MathisRojas/Carte_Wifi/Diagrammes/diagramme_des_exigences.png

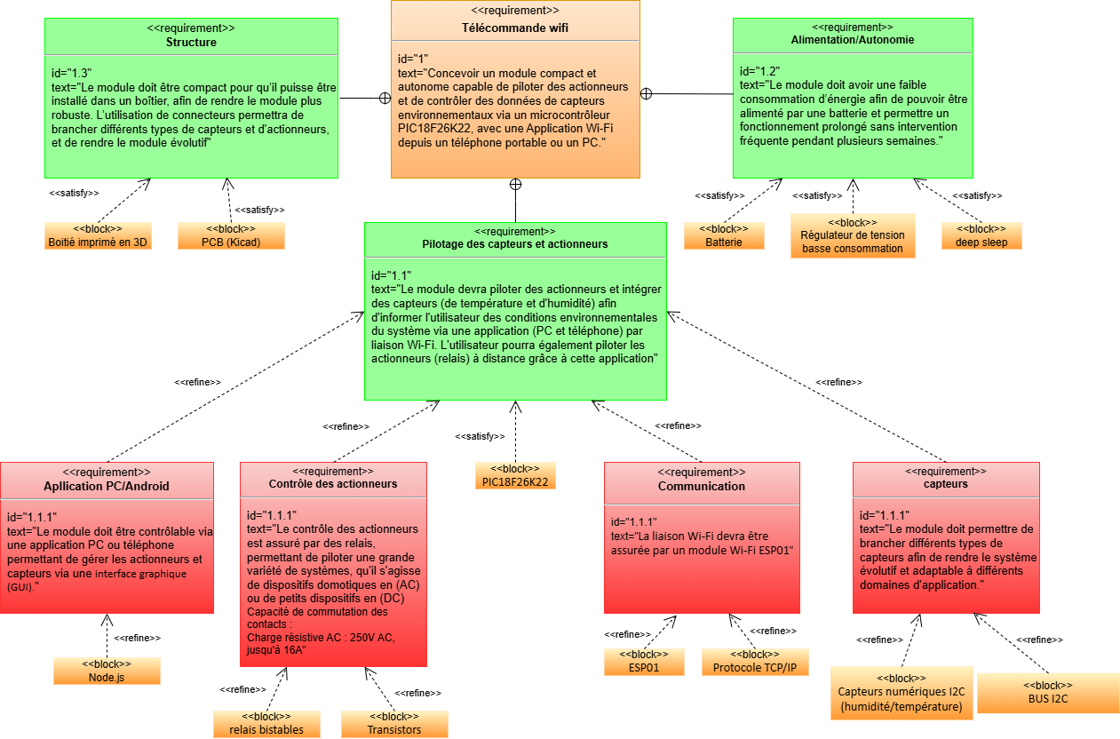
Diagrammes/diagramme_des_exigences.png
