MathisRojas/Carte_Wifi/readme.txt

Ce dossier contient l'ensemble des fichiers relatifs à la réalisation au projet :

1. Bilan produit

	Analyse de l'impact environnemental du projet (BBD 2011).

2. Diagrammes

	Inclut les différents schémas et diagrammes nécessaires à la compréhension du projet :

		Diagrammes des cas d'utilisation
		Diagrammes des exigences
		Algorigrammes

3. Documents utiles

	Regroupe les documents de référence et les documents techniques :

		Bibliographie

		Datasheets des composants utilisés :

			SHT21 (capteur d'humidité et de température)
			Relais
			ESP01 (module Wifi)

4. Electronique

	Documents et fichiers de conception électronique :

		Liste des composants électroniques utilisés (prix et référence fournisseur)
		Carte WiFi : fichier KiCad, typons, plan de perçage et d’implémentation, fichiers G-code et FlatCAM pour CNC
		Carte capteurs : fichier KiCad, typons, plan de perçage et d’implémentation

5. Planning

	Inclut le suivi du projet, le planning prévisionnel et l'état d'avancement des différentes étapes.

6. Programmes

	Contient les fichiers et codes liés aux développements logiciels :

		Carte WiFi : Programme C du microcontrôleur (PIC18F26K22)
		Application Node.js : scripts et fichiers de l'application

7.A la racine du dossier :

	Vidéo de présentation
	Manuel d'utilisation
	Rapport technique du projet
