MathisRojas/Carte_Wifi/Manuel d'utilisation.pdf

# Manuel d’utilisation -Carte Wifi

### 1. Caractéristiques Techniques

- Intervalle d'humidité relative : 0 % à 100 %
- Précision de l'humidité relative : +/- 2 %
- Température de fonctionnement : -40 °C à 125 °C
- Précision de la température : +/- 0.3 °C
- Alimentation : 3V à 6V
- Consommation moyenne : 90 mA à 5,5V

### 2. Mise en service

1. Alimenter la carte avec une tension comprise entre 3V et 6V.
2. Pour Windows, lancer le fichier code-node-js.exe
3. Pour linux, lancer la machine virtuelle mint32, ouvrir le terminal et aller dans le dossier /mnt/Documents/app. Ensuite exécuter ‘node server.js’ et ouvrir le lien qui apparait dans la console.

### 3. Connexion à l'application

1. Scanner les réseaux WiFi disponibles sur votre appareil (ordinateur, smartphone).
2. Sélectionner le SSID "Carte_Wifi".
3. Entrer le mot de passe : "mot_de_passe".
4. Cliquer sur "Se connecter".

### 4. Connexion au serveur TCP

1. Cliquez sur "Se connecter au serveur TCP"
2. Une fois connecté, une page s'affichera avec :
- Une actualisation toutes les 5 secondes des valeurs de la température et de l’humidité.
- Des boutons permettant de permuter l’état des relais à distance.

### 5. En cas de panne

1. Vérifiez que votre appareil reste connecté au réseau "Carte_Wifi".
2. En cas de problème de connexion, appuyez sur le bouton poussoir « reset ESP », puis sur le « bouton poussoir reset PIC ».
3. Si le problème persiste, branchez le Pickit3 sur la carte Wifi et compilez le programme « V8_CMS_FINAL ».

### Fin du manuel
