MathisRojas/Carte_Wifi/application/README.md

Projet Carte-wifi,

Ce projet est fait durant la 2ème année de BUT GEII à l'UGA, parcour ESE

Le but est de faire une caret wifi et une interface pour communiquer avec cette carte et recevoir des informations venant d'un capteur I²C.
