MathisRojas/Carte_Wifi/Diagrammes/algorigramme_Carte_Wifi.png

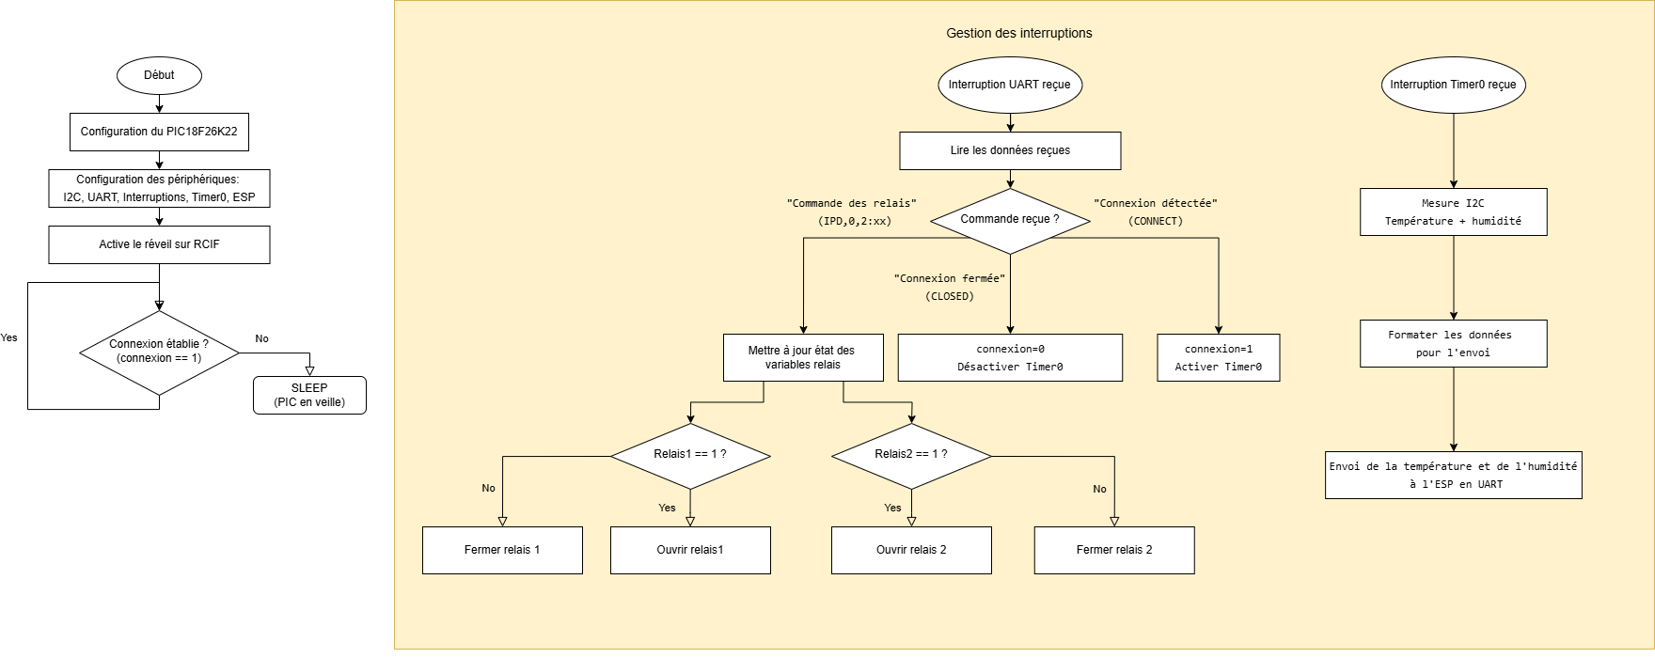
Diagrammes/algorigramme_Carte_Wifi.png
