MathisRojas/Carte_Wifi/Bilan_Produit/Bilan_Produit_Logiciel_Carte_Wifi.xls

Sheet: Crédits
L'Université de Cergy-Pontoise
Retour
Le master professionnel "Sciences de l’Environnement - Milieux Urbains et Industriels" vise à former des spécialistes capables de comprendre les enjeux environnementaux en milieux urbain et industriel, dans le domaine de la communication, de l’éco-conception et de la gestion des déchets. Il bénéficie d’une forte implication des professionnels dans les enseignements, avec notamment des conventions de formation (BRGM, INERIS), des visites de sites industriels (centres d’enfouissement techniques, incinérateurs, etc.) et la participation active des étudiants au salon Pollutec.
La première année (M1) donne aux étudiants une base solide en sciences de l’environnement et s’appuie sur des enseignements en physique, chimie, biologie et sciences de la Terre, complétés par des enseignements transversaux (économie, droit, etc.).
La deuxième année (M2) est constituée d’un tronc commun et de deux parcours séparés :
- parcours éco-conception et gestion des déchets : spécialisation dans les problèmes liés aux déchets, avec en amont la conception de produits plus respectueux de l’environnement, et en aval la gestion, le traitement et la valorisation des déchets ;
- parcours environnement et communication : spécialisation dans les problèmes de communication environnementale interne et externe des entreprises privées et des administrations, notamment dans le cadre de la prévention, ainsi que dans l’analyse et la gestion des risques et des situations de crise.
Développement de Bilan Produit 2008
Développement & mise à jour méthodologie |  |  |  | Jean-François PATINGRE
Développement classeur |  |  |  | Matthieu CHACHAGNE
Correspondant ADEME |  |  | Olivier RETHORE
Origine données |  |  |  | Ecoinvent
Bilan Produit est basé sur le classeur UCPE 2004 développé par : | Jacques VIGNERON - Professeur des Universités, Jean-François PATINGRE & Frédéric Malaval - Professeurs associés, Matthieu CHACHAGNE & Stéphane Splee RABEHANTA - Assistants Recherches
Contacts
Université de Cergy-Pontoise |  | ADEME
Département des Sciences de la Terre et de l'Environnement |  | Service Eco-conception et Consommation Durable
Bâtiment E (Neuville 3.1), 4ème étage, 5, mail Gay Lussac, Neuville-sur-Oise 95031 Cergy-Pontoise Cedex |  | 27 rue Louis Vicat 75737 Paris Cedex 15
 |  | olivier.rethore@ademe.fr
jean-francois.patingre@u-cergy.fr |  | Pour toute question, consulter d'abord la Foire Aux Questions
Retour

Sheet: Pour commencer
Classeur d'Estimation des Impacts Environnementaux des Produits
DEMARRER
Bilan Produit, Base de Données actualisée en 2011
N'oubliez pas | Cellule sur fond jaune |  | = information à saisir
 | - Sur chaque feuille un clic sur le bouton "Aide" fait apparaître un guide d'utilisation et de renseignements.
 | - Pour vous familiariser avec l'outil, vous pouvez consulter l'exemple d'une cafetière intégralement traité dans le manuel d'utilisation du logiciel.
Pour en savoir plus | - Eco-conception, Concept, Méthodes, Outils, Guides et Perspectives ; Collectif ; Ed. Economica - 2001
 | - Eco-concevoir, Appliquer et Communiquer ; Collectif ; Ed. Economica - 2002
 | - Dossier Eco-conception sur le site de l'ADEME (http://www2.ademe.fr/servlet/KBaseShow?sort=-1&cid=96&m=3&catid=12922) | http://www2.ademe.fr/servlet/KBaseShow?sort=-1&cid=96&m=3&catid=12922 | http://www2.ademe.fr/servlet/KBaseShow?sort=-1&cid=96&m=3&catid=12922 | http://www2.ademe.fr/servlet/KBaseShow?sort=-1&cid=96&m=3&catid=12922 | http://www2.ademe.fr/servlet/KBaseShow?sort=-1&cid=96&m=3&catid=12922 | http://www2.ademe.fr/servlet/KBaseShow?sort=-1&cid=96&m=3&catid=12922
Bilan Produit 2008 est basé sur le classeur UCPE 2004 développé par l'équipe éco-conception de l'Université de Cergy-Pontoise, Département Sciences de la Terre et de l'Environnement. Le développement de ce classeur a été rendu possible grâce au soutien financier de l'ADEME Convention n°0377002
Crédits

Sheet: Méthodologie
 | Méthodologie
 | Précédent | Suivant
Description
Projet |  | Carte Wifi
Cas |  | Domotique
Date |  | 2025-03-10
Auteur |  | ROJAS BARRAUD
L'unité fonctionnelle
Pour comparer des produits, différentes solutions de conception ou des options d'optimisations, il est nécessaire de ramener toutes les quantifications (coûts, impacts…) à une même unité d'utilisation : l'Unité d'utilité du produit. Elle ne peut se définir que par rapport à sa fonction pour l'utilisateur. Quel service rend-t-elle ? La définition fonctionnelle sert donc directement à ce choix de la quantification unitaire, on parle alors d'Unité Fonctionnelle. Il faut donc apporter le plus grand soin à la définition d'une unité "commune" d'utilisation des produits et services avant de conclure sur les choix liés à leur éco-conception.
Détermination de l'Unité fonctionnelle
Une démarche Multi-critères & Multi-étapes
Environnement est un terme générique qui englobe des problématiques variées : réchauffement climatique, pollution des sols et des eaux, diminuation de la bio-diversité... Ces questions se manifestent à des échelles géographiques variables (locale, régionale, mondiale) et pour une période temporelle spécifique.
Pour refléter ces particularités, huit indicateurs d'impacts ont été retenus parmi tous ceux disponibles dans la littérature scientifique. Ils représentent les grands enjeux environnementaux de notre époque. On parle alors d'une approche multi-critères.
cf. Manuel Utilisateur (Définition des indicateurs)
L'étude des impacts du produit doit être considérée sur l'ensemble de son cycle de vie : fabrication, transports, utilisation et fin de vie.
D'une part pour ne pas négliger d'impact, à aucun moment. D'autre part pour éviter un phénomène de transfert de pollution. En effet l'étude d'un produit sur une seule phase du cycle de vie peut amener, lors d'une tentative d'amélioration, à baisser les impacts sur la phase considérée mais à conduire à l'augmention d'un ou plusieurs impacts à une autre étape du cycle de vie.
Phase de Production |  | Phase de Transports | Phase d'Utilisation | Fin de vie
La normation des résultats
Les indicateurs d'impacts sont exprimés dans des unités souvent peu parlantes en elles-mêmes (kg CO2 éq, kg SO2 éq...). De plus ils sont exprimés dans des unités et des ordres de grandeurs différents qui ne permettent pas d'établir entre eux une visualisation correcte.
La normation permet de passer outre ces difficultés, en établissant une référence de type temporelle et / ou géographique.
Elle ne permet cependant pas la comparaison entre indicateurs dont les problèmes et les gravités sont de natures différentes et EXCLUE toutes additivités entre eux.
Une valeur d'indicateur d'Effet de serre ne peut pas être comparée à une valeur d'indicateur de la Toxicité humaire.
La normation consiste à effectuer le rapport entre la valeur de l'impact du produit et la valeur de référence de la normation.
La normation effectuée dans ce logiciel se fait par rapport aux valeurs d'impacts de la consommation moyenne d'un européen sur une journée (Europe des Quinze). Les résultats sont alors exprimés en point UCPE (Unité de Compte de Profil Environnemental).
Il est possible de modifier ces paramètres pour changer de zone géographique, ou de durée. Cela nécessite une réflexion importante pour exclure tous doubles comptes. Pour modifier ou consulter les paramètres de normalisation, cliquez sur le bouton "Expert".
Expression des résultats
Les résultats de l'analyse sont visualisés sous formes de graphiques présentant les résultats normés et de tableaux dans lesquels les valeurs sont données sans normation.
Les résultats
Exploitation des résultats
Pour que les résultats puissent être considérés comme conformes aux normes ISO 14040 et ISO 14044 sur l'analyse de cycle de vie, il faut que la modélisation ait été soumise à revue critique.

Sheet: Unité Fonctionnelle
 | Calcul du coefficient d'unité fonctionnelle
 | Précédent | Suivant
Coefficient d'Unité Fonctionnelle (CUF)
Entrez, dans l'encadré, le coefficient d'unité fonctionnelle que vous avez déterminé :……..……………………….…………….……………..
 |  |  |  | …………….. | 1
Entrez une brève description du système modélisé :
 | 24h/24h 7j/7j
L'unité fonctionnelle peut s'exprimer sous la forme :
 | - d'une durée de vie,
 | - d'un nombre de cycle de fonctionnement,
 | - d'une quantité (consommée, de production…).
- Exemple 1 : cas d'une machine à café
A\ Unité fonctionnelle : Préparer le café du petit-déjeuner pour une famille de 4 personnes durant 5 ans.
On prend comme hypothèse que cela correspond à 300 préparations par an soit 1500 pour la période retenue.
Si la machine étudiée est prévue pour 1200 cycles de préparation de café,
 | alors le CUF équivaut à : 1500 / 1200 = 1,25
B\ Unité fonctionnelle évaluée pour une durée de 1 an.
Si la machine est prévue pour durer 5 ans,
 | Ici le CUF équivaut à : 1 / 5 = 0,2
- Exemple 2 : comparaison entre différent conditionnement d'eau minérale
Etude de la consommation d'eau minérale d'une personne sur un an, environ 150 litres.
3 cas étudiés :
 |  |  | CUF
 | Bouteille de verre de 1L |  | 150
 | Bouteille de plastique (PET) de 50 cL |  | 300
 | Cannette en Alu de 33 cL |  | 455
Voir exemples du manuel utilisateur

Sheet: Phase de Production
 | Phase de Production
 | Précédent | Suivant
 | Tableau des éléments (Composants…) du produit
Sous-ensemble | Nom | Quantité | Unité | Commentaires utilisateur
PCB | Circuit imprimé composants traversants (surface) | 0.00299 | m2 | PCB
PCB2 | Circuit imprimé CMS (surface) | 0.000225 | m2 | PCB_capteurs
PCBA | Composant électronique passif (moyenne) | 0.00684 | kg | capacités
PCBA | Composant électronique actif (moyenne) | 0.00033 | kg | diodes
PCBA | Composant électronique actif (moyenne) | 4.2e-05 | kg | XC9236A33DMR-G
PCBA | Composant électronique passif (moyenne) | 4e-05 | kg | inductance
PCBA | Composant électronique passif (moyenne) | 5.5e-08 | kg | résistances
PCBA | Composants de panneau d'ordinateur | 4.5e-05 | kg | embases à broches males
PCBA | Composants de panneau d'ordinateur | 0.0055 | kg | borniers
PCBA | Composants de panneau d'ordinateur | 0.000938 | kg | Embases et logements de câbles
PCBA | Composant électronique passif (moyenne) | 0.028 | kg | Relais RT314F03
PCBA | Module electronique de commande | 0.001 | kg | ESP
PCBA | Module electronique de commande | 0.000792 | kg | PIC
PCBA | Composant électronique passif (moyenne) | 0.004 | kg | boutons poussoirs
PCBA | Composant électronique actif (moyenne) | 4e-05 | kg | Transistors
PCBB | Module electronique de commande | 2.5e-05 | kg | SHT21

Sheet: Phase de Transports
 | Phase de Transports
 | Précédent | Suivant
 | Tableau des transports liés au produit
Sous-ensemble | Nom | Quantité | Unité | Commentaires utilisateur
TRANSPORT | Transport transocéanique | 1.026 | t.km | Distance : 18000km Masse transportée : 0,057kg
TRANSPORT | Petit camion 3,5 à 16 T (moyenne européenne) | 0.017328 | t.km | Distance : 304km Masse transportée : 0,057kg

Sheet: Phase Utilisation
 | Phase d'Utilisation
 | Précédent | Suivant
 | Tableau des éléments (Composants…) du produit
Sous-ensemble | Nom | Quantité | Unité | Commentaires utilisateur
électricité | Electricité basse tension France | 0.0003 | kWh

Sheet: Fin de vie
 |  | Fin de vie
 |  | Précédent | Suivant
 | Nom du scénario : | Déchets ménagers
Phase de vie | Sous-ensemble | Matériaux | % Recyclage | % Incinération | % Enfouissement | % Compostage | Validation
Phase de Production | PCB | Circuit imprimé composants traversants (surface) | 75.00% | 12.50% | 12.50% | 0.00% | 100.00%
Phase de Production | PCB2 | Circuit imprimé CMS (surface) | 75.00% | 12.50% | 12.50% | 0.00% | 100.00%
Phase de Production | PCBA | Composant électronique passif (moyenne) | 75.00% | 12.50% | 12.50% | 0.00% | 100.00%
Phase de Production | PCBA | Composant électronique actif (moyenne) | 75.00% | 12.50% | 12.50% | 0.00% | 100.00%
Phase de Production | PCBA | Composant électronique actif (moyenne) | 75.00% | 12.50% | 12.50% | 0.00% | 100.00%
Phase de Production | PCBA | Composant électronique passif (moyenne) | 75.00% | 12.50% | 12.50% | 0.00% | 100.00%
Phase de Production | PCBA | Composant électronique passif (moyenne) | 75.00% | 12.50% | 12.50% | 0.00% | 100.00%
Phase de Production | PCBA | Composants de panneau d'ordinateur | 75.00% | 12.50% | 12.50% | 0.00% | 100.00%
Phase de Production | PCBA | Composants de panneau d'ordinateur | 75.00% | 12.50% | 12.50% | 0.00% | 100.00%
Phase de Production | PCBA | Composants de panneau d'ordinateur | 75.00% | 12.50% | 12.50% | 0.00% | 100.00%
Phase de Production | PCBA | Composant électronique passif (moyenne) | 75.00% | 12.50% | 12.50% | 0.00% | 100.00%
Phase de Production | PCBA | Module electronique de commande | 75.00% | 12.50% | 12.50% | 0.00% | 100.00%
Phase de Production | PCBA | Module electronique de commande | 75.00% | 12.50% | 12.50% | 0.00% | 100.00%
Phase de Production | PCBA | Composant électronique passif (moyenne) | 75.00% | 12.50% | 12.50% | 0.00% | 100.00%
Phase de Production | PCBA | Composant électronique actif (moyenne) | 75.00% | 12.50% | 12.50% | 0.00% | 100.00%
Phase de Production | PCBB | Module electronique de commande | 75.00% | 12.50% | 12.50% | 0.00% | 100.00%

Sheet: Résultats
 |  | Résultats
 | Précédent
Impacts par phase de vie
Indicateurs | Phase de Production | Phase de Transports | Phase Utilisation | Fin de vie |  | Total
Consommation énergie NR (MJ eq) | 59.91886105 | 0.2475498154 | 0.00390024027 | 0 |  | 60.1703111
Consommation ressources (kg Sb eq) | 0.02834421451 | 0.0001049200368 | 2.14968e-07 | 0 |  | 0.02844934952
Effet de serre GWP 100 mod (kg CO2 eq) | 3.707115544 | 0.01546603344 | 3.2235e-05 | 0 |  | 3.722613813
Acidification (kg SO2 eq) | 0.05455235361 | 0.000265083744 | 2.03523e-07 | 0 |  | 0.05481764088
Eutrophisation (air eau sol) (kg PO4--- eq) | 0.026293604 | 3.273683736e-05 | 8.8719e-08 | 0 |  | 0.02632642956
Pollution photochimique (kg C2H4) | 0.004324063094 | 8.42518368e-06 | 7.917e-09 | 0 |  | 0.004332496194
Ecotoxicité aquatique (kg 1,4-DB eq) | 6.328833806 | 0.001659267264 | 2.17398e-05 | 0 |  | 6.330514813
Toxicité humaine (kg 1,4-DB eq) | 10.53276769 | 0.008838226656 | 7.3245e-05 | 0 |  | 10.54167916
Impacts par Sous-ensemble - Phase de Production
Indicateurs | Circuit imprimé composants traversants (surface) (PCB) | Circuit imprimé CMS (surface) (PCB2) | Composant électronique passif (moyenne) (PCBA) | Composant électronique actif (moyenne) (PCBA) | Composant électronique actif (moyenne) (PCBA) | Composant électronique passif (moyenne) (PCBA) | Composant électronique passif (moyenne) (PCBA) | Composants de panneau d'ordinateur (PCBA) | Composants de panneau d'ordinateur (PCBA) | Composants de panneau d'ordinateur (PCBA) | Composant électronique passif (moyenne) (PCBA) | Module electronique de commande (PCBA) | Module electronique de commande (PCBA) | Composant électronique passif (moyenne) (PCBA) | Composant électronique actif (moyenne) (PCBA) | Module electronique de commande (PCBB)
Consommation énergie NR (MJ eq) | 5.480768744 | 1.138208479 | 5.762103223 | 3.844569938 | 0.4893089011 | 0.03369651008 | 4.633270135e-05 | 0.1038515197 | 12.69296352 | 2.164727233 | 23.58755705 | 0.4322510245 | 0.3423428114 | 3.369651008 | 0.4660084773 | 0.01080627561
Consommation ressources (kg Sb eq) | 0.0021969922 | 0.000444105 | 0.0027887364 | 0.001725009 | 0.0002195466 | 1.63084e-05 | 2.242405e-08 | 5.0985e-05 | 0.0062315 | 0.001062754 | 0.01141588 | 0.00019397 | 0.00015362424 | 0.00163084 | 0.000209092 | 4.84925e-06
Effet de serre GWP 100 mod (kg CO2 eq) | 0.3072225 | 0.064161 | 0.33456492 | 0.2420847 | 0.03081078 | 0.00195652 | 2.690215e-06 | 0.00752895 | 0.920205 | 0.15693678 | 1.369564 | 0.025912 | 0.020522304 | 0.195652 | 0.0293436 | 0.0006478
Acidification (kg SO2 eq) | 0.0015760589 | 0.0003422025 | 0.007546572 | 0.001210506 | 0.0001540644 | 4.4132e-05 | 6.06815e-08 | 5.47785e-05 | 0.00669515 | 0.0011418274 | 0.0308924 | 0.00018419 | 0.00014587848 | 0.0044132 | 0.000146728 | 4.60475e-06
Eutrophisation (air eau sol) (kg PO4--- eq) | 0.0011725584 | 0.000325665 | 0.00346617 | 0.002785629 | 0.0003545346 | 2.027e-05 | 2.787125e-08 | 8.06805e-06 | 0.000986095 | 0.00016817402 | 0.014189 | 0.00024918 | 0.00019735056 | 0.002027 | 0.000337652 | 6.2295e-06
Pollution photochimique (kg C2H4) | 7.139522e-05 | 1.4292225e-05 | 0.00067488912 | 4.44807e-05 | 5.66118e-06 | 3.94672e-06 | 5.42674e-09 | 2.26737e-06 | 0.000277123 | 4.7262068e-05 | 0.002762704 | 1.0992e-05 | 8.705664e-06 | 0.000394672 | 5.3916e-06 | 2.748e-07
Ecotoxicité aquatique (kg 1,4-DB eq) | 0.26007618 | 0.06460425 | 0.853974 | 0.683529 | 0.0869946 | 0.004994 | 6.86675e-06 | 0.00128421 | 0.156959 | 0.026768644 | 3.4958 | 0.061415 | 0.04864068 | 0.4994 | 0.082852 | 0.001535375
Toxicité humaine (kg 1,4-DB eq) | 0.7112911 | 0.150975 | 1.390572 | 0.957957 | 0.1219218 | 0.008132 | 1.11815e-05 | 0.00266571 | 0.325809 | 0.055565244 | 5.6924 | 0.10245 | 0.0811404 | 0.8132 | 0.116116 | 0.00256125
Impacts par Sous-ensemble - Phase de Transports
Indicateurs | Transport transocéanique (TRANSPORT) | Petit camion 3,5 à 16 T (moyenne européenne) (TRANSPORT)
Consommation énergie NR (MJ eq) | 0.1716089522 | 0.07594086319
Consommation ressources (kg Sb eq) | 7.3268712e-05 | 3.16513248e-05
Effet de serre GWP 100 mod (kg CO2 eq) | 0.011013084 | 0.00445294944
Acidification (kg SO2 eq) | 0.0002417256 | 2.3358144e-05
Eutrophisation (air eau sol) (kg PO4--- eq) | 2.641437e-05 | 6.32246736e-06
Pollution photochimique (kg C2H4) | 7.68987e-06 | 7.3531368e-07
Ecotoxicité aquatique (kg 1,4-DB eq) | 0.0012262752 | 0.000432992064
Toxicité humaine (kg 1,4-DB eq) | 0.0076603212 | 0.001177905456
Impacts par Sous-ensemble - Phase Utilisation
Indicateurs | Electricité basse tension France (électricité)
Consommation énergie NR (MJ eq) | 0.00390024027
Consommation ressources (kg Sb eq) | 2.14968e-07
Effet de serre GWP 100 mod (kg CO2 eq) | 3.2235e-05
Acidification (kg SO2 eq) | 2.03523e-07
Eutrophisation (air eau sol) (kg PO4--- eq) | 8.8719e-08
Pollution photochimique (kg C2H4) | 7.917e-09
Ecotoxicité aquatique (kg 1,4-DB eq) | 2.17398e-05
Toxicité humaine (kg 1,4-DB eq) | 7.3245e-05
Impacts par Sous-ensemble - Fin de vie
Indicateurs | Circuit imprimé composants traversants (surface) (Phase de Production : PCB) | Circuit imprimé CMS (surface) (Phase de Production : PCB2) | Composant électronique passif (moyenne) (Phase de Production : PCBA) | Composant électronique actif (moyenne) (Phase de Production : PCBA) | Composant électronique actif (moyenne) (Phase de Production : PCBA) | Composant électronique passif (moyenne) (Phase de Production : PCBA) | Composant électronique passif (moyenne) (Phase de Production : PCBA) | Composants de panneau d'ordinateur (Phase de Production : PCBA) | Composants de panneau d'ordinateur (Phase de Production : PCBA) | Composants de panneau d'ordinateur (Phase de Production : PCBA) | Composant électronique passif (moyenne) (Phase de Production : PCBA) | Module electronique de commande (Phase de Production : PCBA) | Module electronique de commande (Phase de Production : PCBA) | Composant électronique passif (moyenne) (Phase de Production : PCBA) | Composant électronique actif (moyenne) (Phase de Production : PCBA) | Module electronique de commande (Phase de Production : PCBB)
Consommation énergie NR (MJ eq) | 0 | 0 | 0 | 0 | 0 | 0 | 0 | 0 | 0 | 0 | 0 | 0 | 0 | 0 | 0 | 0
Consommation ressources (kg Sb eq) | 0 | 0 | 0 | 0 | 0 | 0 | 0 | 0 | 0 | 0 | 0 | 0 | 0 | 0 | 0 | 0
Effet de serre GWP 100 mod (kg CO2 eq) | 0 | 0 | 0 | 0 | 0 | 0 | 0 | 0 | 0 | 0 | 0 | 0 | 0 | 0 | 0 | 0
Acidification (kg SO2 eq) | 0 | 0 | 0 | 0 | 0 | 0 | 0 | 0 | 0 | 0 | 0 | 0 | 0 | 0 | 0 | 0
Eutrophisation (air eau sol) (kg PO4--- eq) | 0 | 0 | 0 | 0 | 0 | 0 | 0 | 0 | 0 | 0 | 0 | 0 | 0 | 0 | 0 | 0
Pollution photochimique (kg C2H4) | 0 | 0 | 0 | 0 | 0 | 0 | 0 | 0 | 0 | 0 | 0 | 0 | 0 | 0 | 0 | 0
Ecotoxicité aquatique (kg 1,4-DB eq) | 0 | 0 | 0 | 0 | 0 | 0 | 0 | 0 | 0 | 0 | 0 | 0 | 0 | 0 | 0 | 0
Toxicité humaine (kg 1,4-DB eq) | 0 | 0 | 0 | 0 | 0 | 0 | 0 | 0 | 0 | 0 | 0 | 0 | 0 | 0 | 0 | 0
