MathisRojas/Carte_Wifi/Electronique/Liste_des_composants_électroniques.xls

Désignation // Référence | Qte | PU HT | PT HT | OBSERVATIONS | FOURNISSEUR
2948328 | 5 |  | 3.29 | Transistors NPN (2SCR514RTL) | Farnell (https://fr.farnell.com/rohm/2scr514rtl/transistor-npn-80v-0-7a-sot-346t/dp/2948328)
1855468 | 1 | 8.39 | 8.39 | SHT21 capteur de température et d'humidité en I2C | Farnell (https://fr.farnell.com/sensirion/sht21/capteur-humidite-temperature-num/dp/1855468)
2432863 | 2 | 4.11 | 8.22 | G5RLU1E DC3 relai bistable 3VDC | Farnell (https://fr.farnell.com/omron/g5rlu1edc3/relais-spdt-250vac-24vdc-16a/dp/2432863)
3535681 | 1 | 1.74 | 1.74 | XC9236A33DMR-G Régulateur de tension à découpage 3,3V | Farnell (https://fr.farnell.com/torex/xc9236a33dmr-g/conv-dc-dc-sync-buck-3mhz-85-c/dp/3535681)
2084899 | 1 | 0.35 | 0.35 | NR3015T1R5N inductance 1,5uH | Farnell (https://fr.farnell.com/taiyo-yuden/nr3015t1r5n/inductor-shielded-1-5uh-1-8a-smd/dp/2084899)
34952 | 1 | 8.25 | 8.25 | ESP01 | GOTRONIC (https://www.gotronic.fr/art-module-wifi-esp-01-25664.htm)
715-4454 | 1 | 3.26 | 3.26 | PIC18F26K22 (CMS) | RS (https://fr.rs-online.com/web/p/microcontroleurs/7154454)
 | 2 | 3.74 | 7.48 | Relais (RT314F03) | AliExpress (https://fr.aliexpress.com/item/4000871580820.html)
2675138 | 5 |  | 4.24 | Diodes (SS24) | Farnell (https://fr.farnell.com/multicomp-pro/ss24/redresseur-schottky-2a-40v-do/dp/2675138)
3924322 | 5 |  | 1.02 | Condensateur céramique 100nF 1206 | Farnell (https://fr.farnell.com/yageo/cs1206kkx7rybb104/condensateur-0-1uf-250v-mlcc-1206/dp/3924322)
708-3841 | 5 |  | 5.39 | Condensateur Radial 1000μF | RS (https://fr.rs-online.com/web/p/condensateurs-electrolytiques-aluminium/7083841?gb=s)
4166270 | 5 |  | 1.38 | Condensateur céramique 4.7 µf 1206 | Farnell (https://fr.farnell.com/yageo/cs1206kkx7r8bb475/cond-4-7uf-25v-mlcc-1206/dp/4166270)
4167011 | 5 |  | 1.15 | Condensateur céramique 10µf 1206 | Farnell (https://fr.farnell.com/yageo/cc1206mkx5r5bb106/cond-10uf-6-3v-mlcc-1206/dp/4167011)
767-0996 | 3 | 0.75 | 2.25 | Embase à broches 8 pôles 2.54mm 1 rangée | RS (https://fr.rs-online.com/web/p/embases-circuits-imprimes/7670996?matchtype=&gad_source=1&gclsrc=aw.ds)
765-5626 | 1 | 1.94 | 1.94 | Connecteur femelle, 8 contacts, 2 rangées, 2.54mm | RS (https://fr.rs-online.com/web/p/connecteurs-femelles-pour-ci/7655626?matchtype=&gad_source=1&gclsrc=aw.ds)
269-3801 | 2 | 0.25 | 0.50 | Interrupteur tactile Schurter Traversant | RS (https://fr.rs-online.com/web/p/interrupteurs-tactiles/2693801?matchtype=&gad_source=1&gclsrc=aw.ds)
3498390 | 2 | 0.91 | 1.82 | Bornier fil-à-carte, 5 mm, 3 Voies | farnell (https://fr.farnell.com/camdenboss/ctb0100-3/terminal-block-interlocking-3/dp/3498390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)
826-7282 | 1 | 0.85 | 0.85 | Bornier 2 contacts 1 rangée | RS (https://fr.rs-online.com/web/p/borniers-pour-circuits-imprimes/8267282?matchtype=&gad_source=1&gclsrc=aw.ds)
668-8524 | 2 | 0.95 | 1.90 | Résistance CMS 10kΩ, 0805 (2012M) ±0.1% (lot de 5) | RS (https://fr.rs-online.com/web/p/resistances-a-montage-en-surface/6688524?gb=s)
3599183 | 1 | 2.47 | 2.47 | Résistance à puce CMS, 2.2 kohm, ± 0.5% (lot de 10) | farnell (https://fr.farnell.com/panasonic/erjup6d2201v/res-2k2-0-5-0-5w-0805/dp/3599183)
 |  |  | 0.00
 |  |  | 0.00
 |  |  | 0.00
 |  |  | 0.00
 | TOTAL HT = |  | 65.89
 | TVA 20% = |  | 13.18
 | TOTAL TTC = |  | 79.07
