MathisRojas/Carte_Wifi/Electronique/bibliothèque/2SCR514RTL/3D/2SCR514RTL.stp

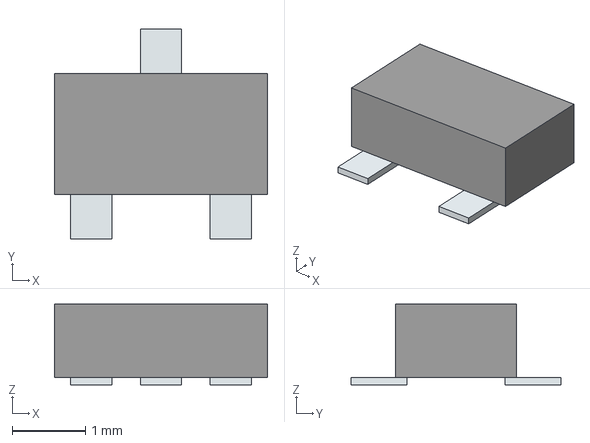
[picture p23: CAD file, 2025-04-15]
Electronique/bibliothèque/2SCR514RTL/3D/2SCR514RTL.stp
2.90 x 2.86 x 1.10 mm
Pins
