MathisRojas/Carte_Wifi/Electronique/bibliothèque/ESP-01.step

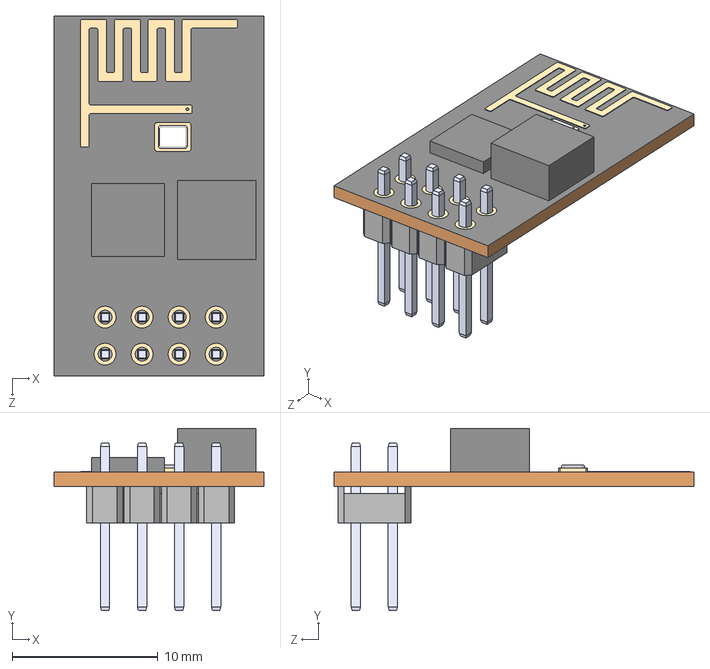
[picture p24: CAD file, 2025-04-15]
Electronique/bibliothèque/ESP-01.step
14.4 x 12.5 x 24.7 mm
