MathisRojas/Carte_Wifi/Electronique/bibliothèque/Librairie_Kicad_2021_11_29/STEP/L7815CV.step

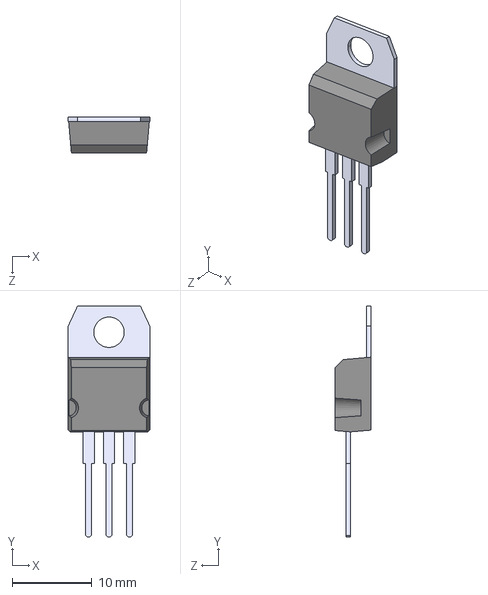
[picture p25: CAD file, 2025-04-15]
Electronique/bibliothèque/Librairie_Kicad_2021_11_29/STEP/L7815CV.step
10.2 x 28.9 x 4.50 mm
