MathisRojas/Carte_Wifi/Electronique/bibliothèque/SHT21/3D/SHT21.stp

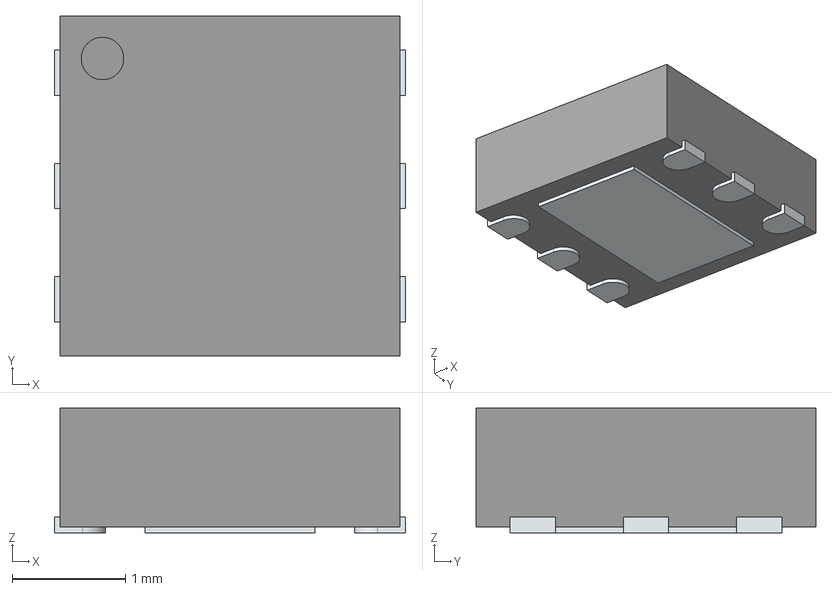
[picture p26: CAD file, 2025-04-15]
Electronique/bibliothèque/SHT21/3D/SHT21.stp
3.10 x 3.00 x 1.10 mm
ThermalPin
PinsArrayLR
