MathisRojas/Carte_Wifi/Electronique/bibliothèque/XC9236A33DMR-G/3D/XC9236A33DMR-G.stp

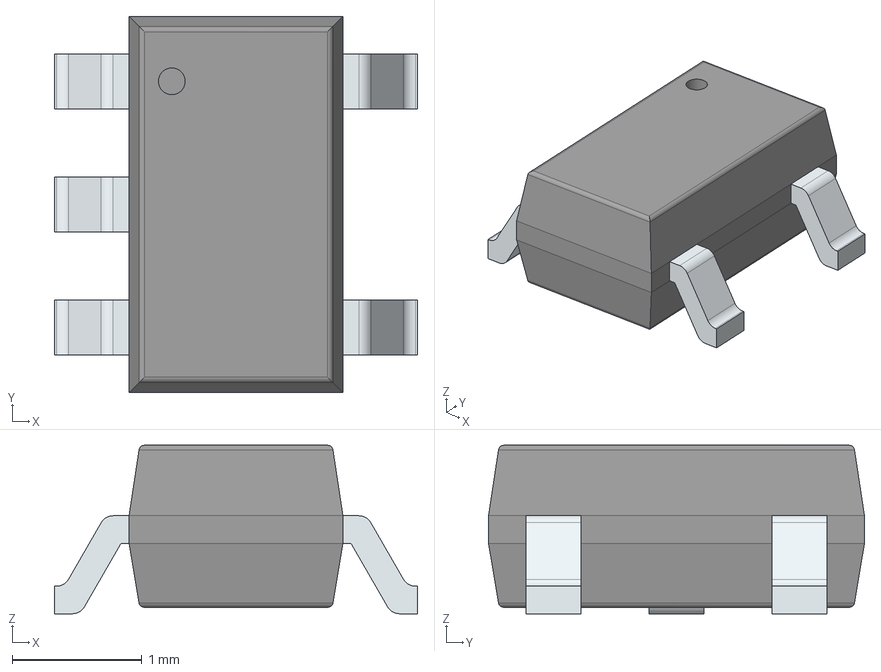
[picture p27: CAD file, 2025-04-15]
Electronique/bibliothèque/XC9236A33DMR-G/3D/XC9236A33DMR-G.stp
2.80 x 2.90 x 1.30 mm
PinsArrayL
PinsArrayR
