MathisRojas/Carte_Wifi/(list of files, cad)

Other CAD files:
Electronique/bibliothèque/2SCR514RTL/Allegro/2scr514rtl.psm
Electronique/bibliothèque/2SCR514RTL/DEHDL/2scr514rtl/chips/chips.prt
Electronique/bibliothèque/G5RL-U1-E-DC3/Allegro/g5rlu1e.psm
Electronique/bibliothèque/G5RL-U1-E-DC3/DEHDL/g5rl_u1_e_dc3/chips/chips.prt
Electronique/bibliothèque/NR3015T1R5N/Allegro/nr3015.psm
Electronique/bibliothèque/NR3015T1R5N/DEHDL/nr3015t1r5n/chips/chips.prt
Electronique/bibliothèque/SHT21/Allegro/son100p300x300x110-7n-d.psm
Electronique/bibliothèque/SHT21/DEHDL/sht21/chips/chips.prt
Electronique/bibliothèque/XC9236A33DMR-G/Allegro/sot95p280x130-5n.psm
Electronique/bibliothèque/XC9236A33DMR-G/DEHDL/xc9236a33dmr_g/chips/chips.prt
