MathisRojas/Carte_Wifi/application/install.txt

npm install electron V34.2.1
npm install express
