MathisRojas/Carte_Wifi/Electronique/Carte_capteur_(SHT21)/implantation des composants Bottom.Silks.pdf

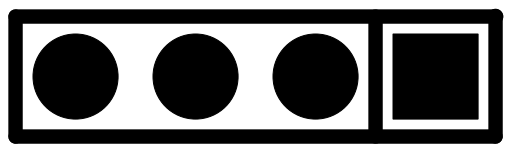
[picture p28: page 1]
