MathisRojas/Carte_Wifi/Electronique/Carte_capteur_(SHT21)/Plan_de_percage.pdf

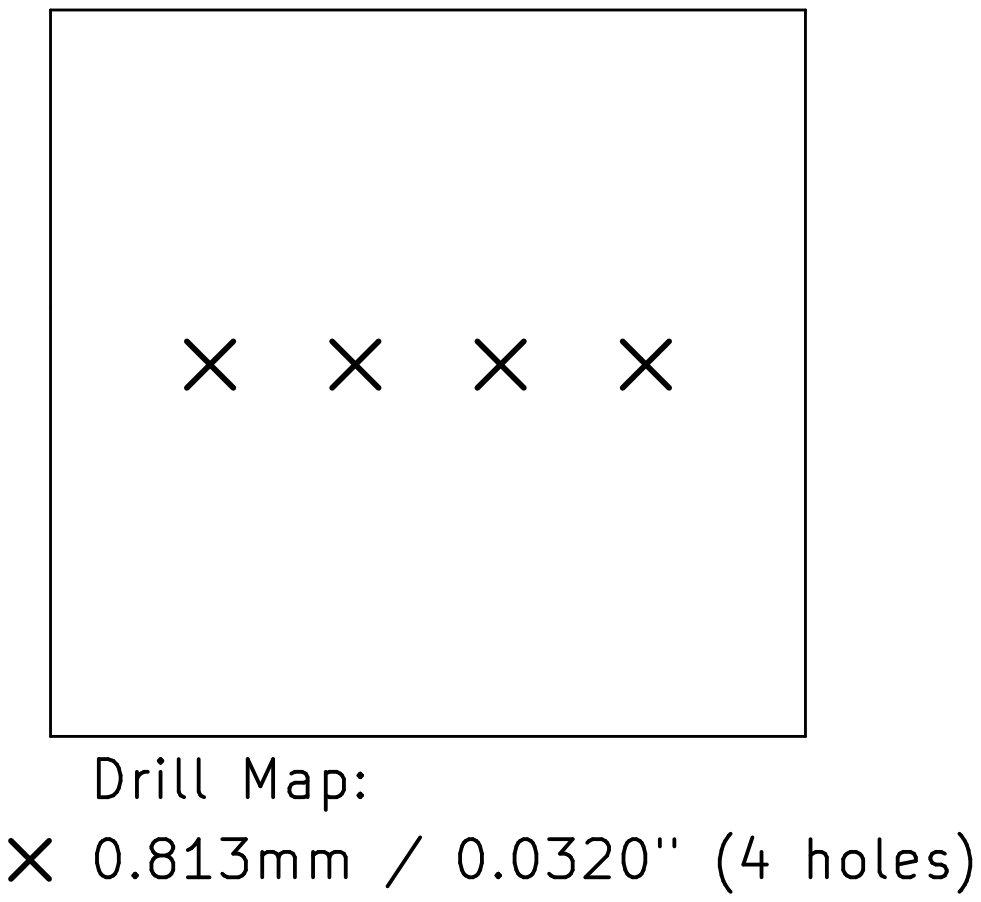
[picture p29: page 1]
