MathisRojas/Carte_Wifi/Electronique/Carte_capteur_(SHT21)/Typon Couche du dessus F.Cu (en miroir).pdf

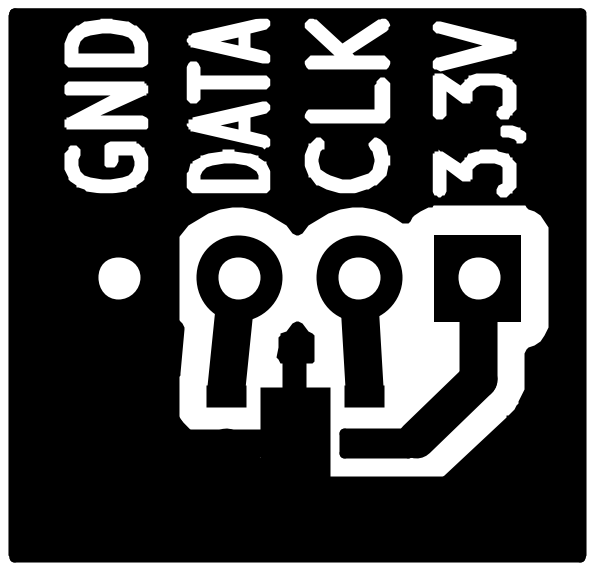
[picture p30: page 1]
