MathisRojas/Carte_Wifi/Electronique/Carte Wifi/V11_(Carte_2)/implantation des composants Bottom.pdf

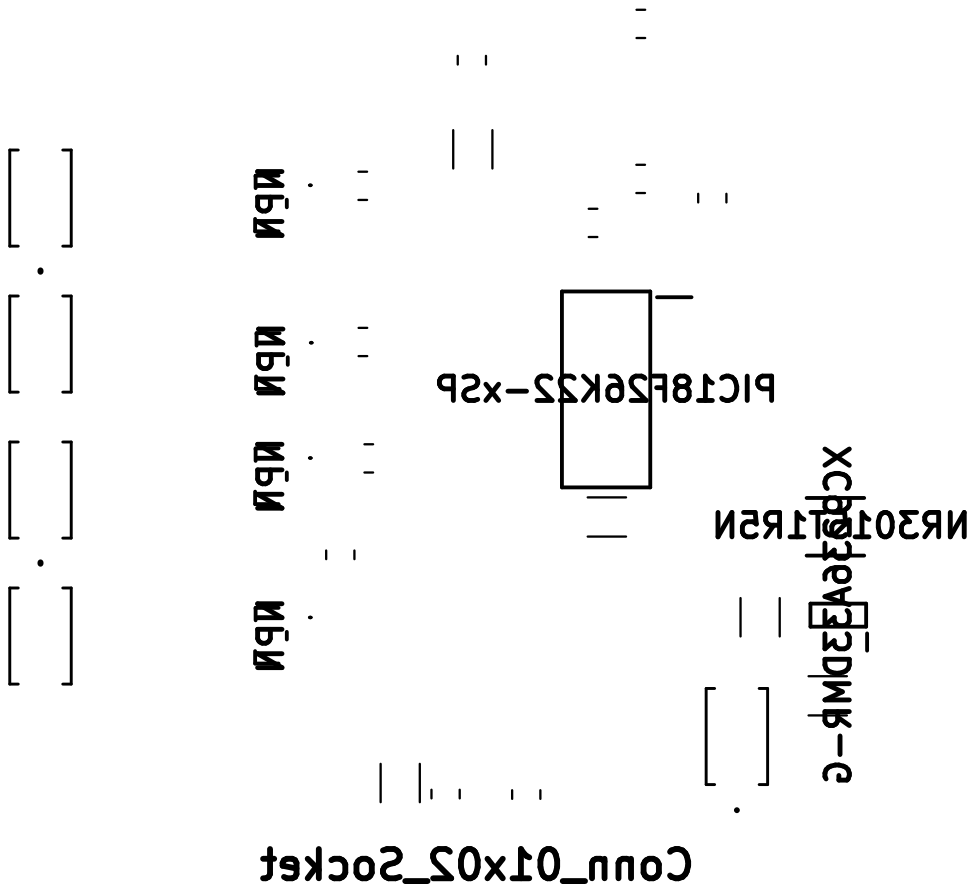
[picture p31: page 1]

PIC18F26K22-xSP NPN NPN NPN
