MathisRojas/Carte_Wifi/Electronique/Carte Wifi/V11_(Carte_2)/implantation des composants Front.pdf

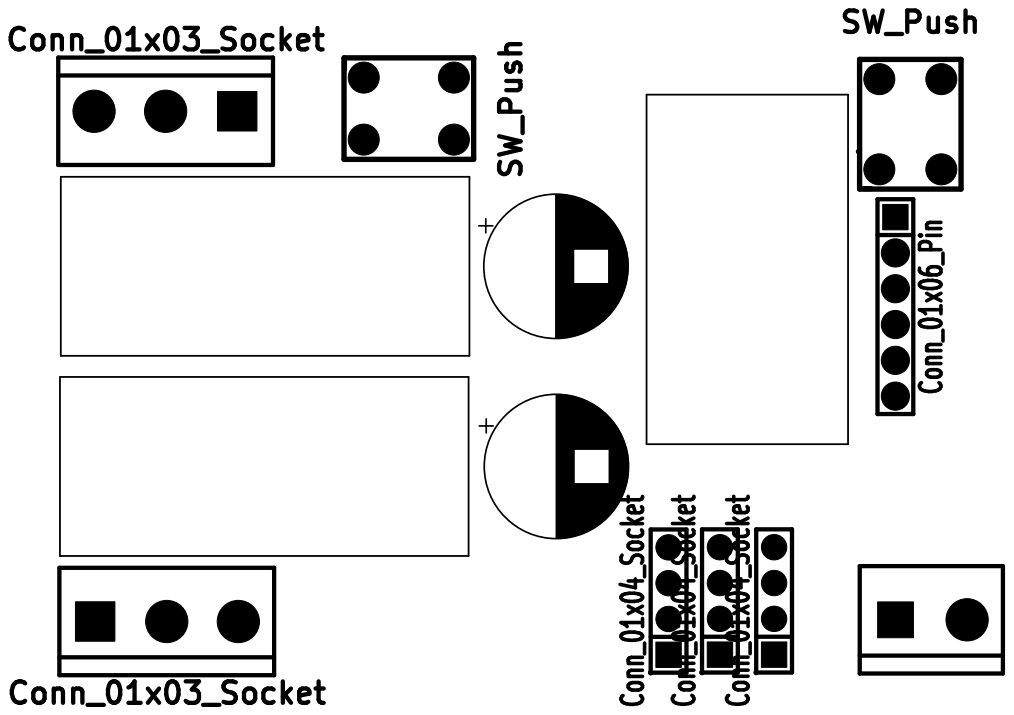
[picture p32: page 1]
