MathisRojas/Carte_Wifi/Electronique/Carte Wifi/V11_(Carte_2)/Plan_de_perçage.pdf

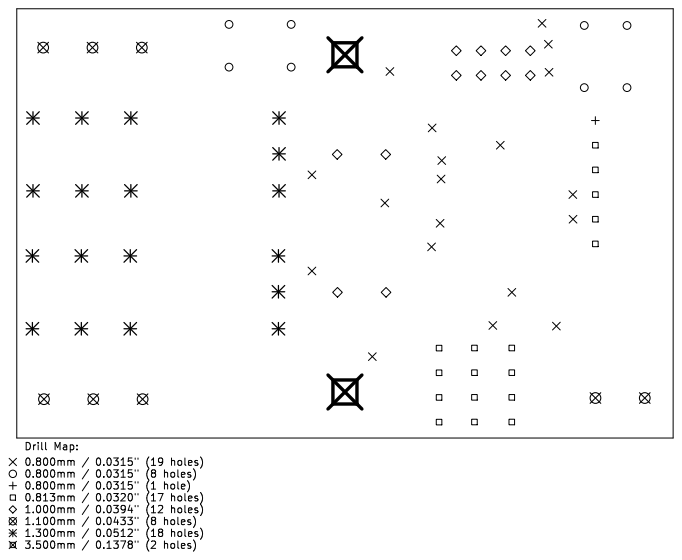
[picture p33: page 1]
