MathisRojas/Carte_Wifi/Electronique/Carte Wifi/V11_(Carte_2)/Typon_Bottom.pdf

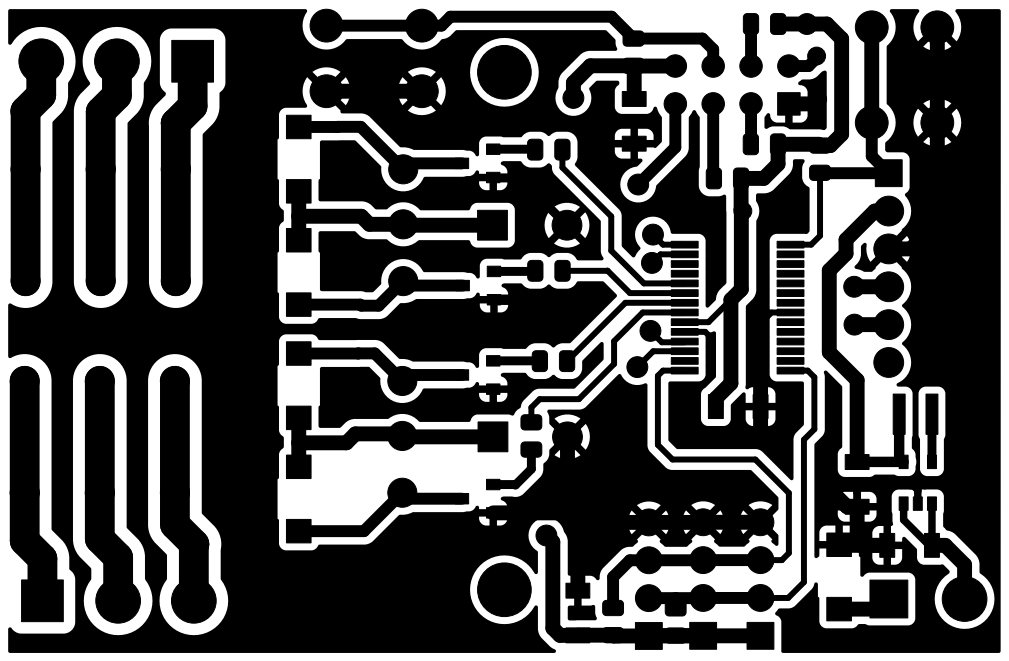
[picture p34: page 1]
