MathisRojas/Carte_Wifi/Electronique/Carte Wifi/V11_(Carte_2)/Typon_Front.pdf

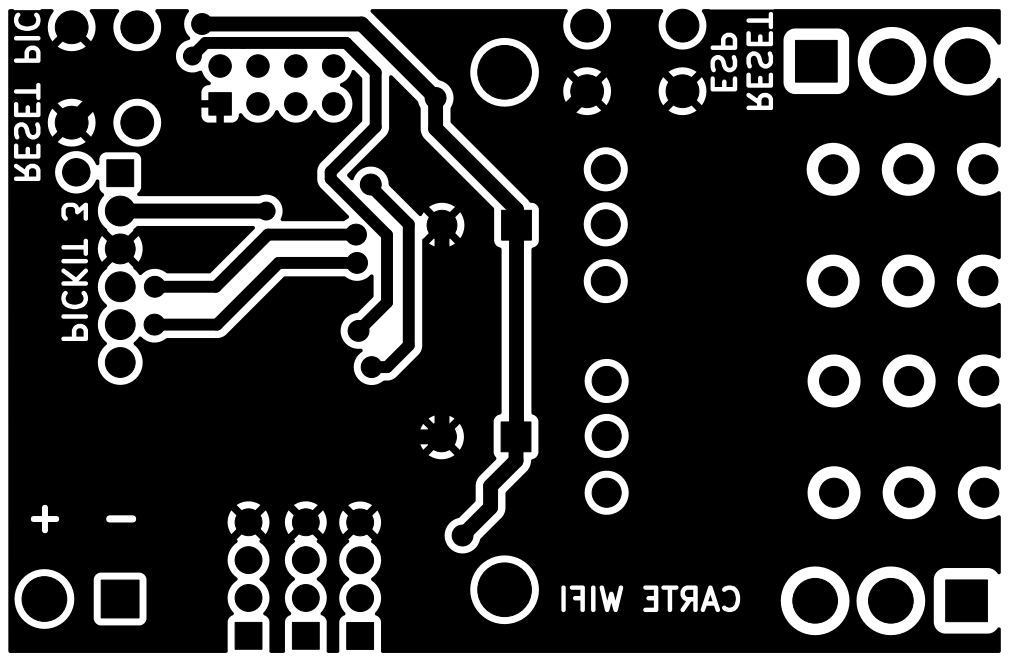
[picture p35: page 1]
