MathisRojas/Carte_Wifi/Electronique/Carte Wifi/V8_(Carte_1)/implantation des composants Bottom.Silks.pdf

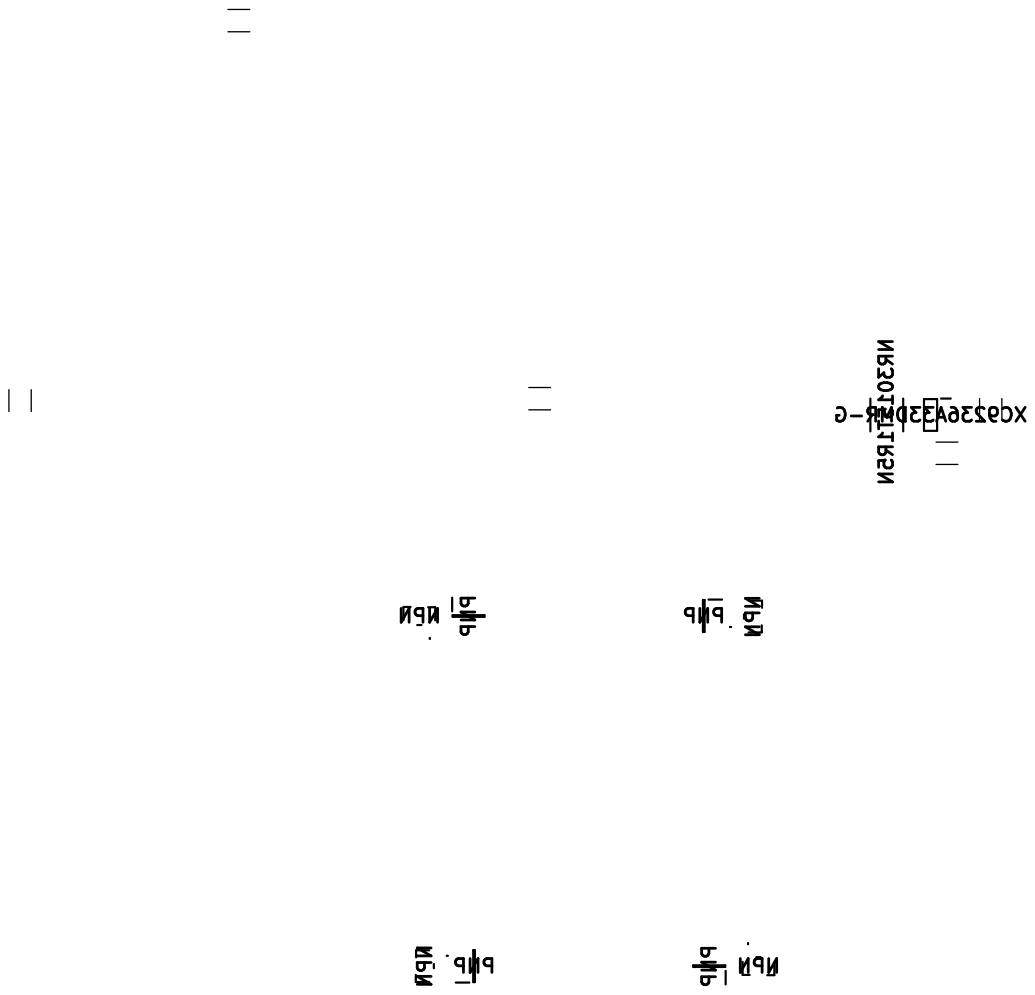
[picture p36: page 1]
