MathisRojas/Carte_Wifi/Electronique/Carte Wifi/V8_(Carte_1)/implantation des composants Front.Silks.pdf

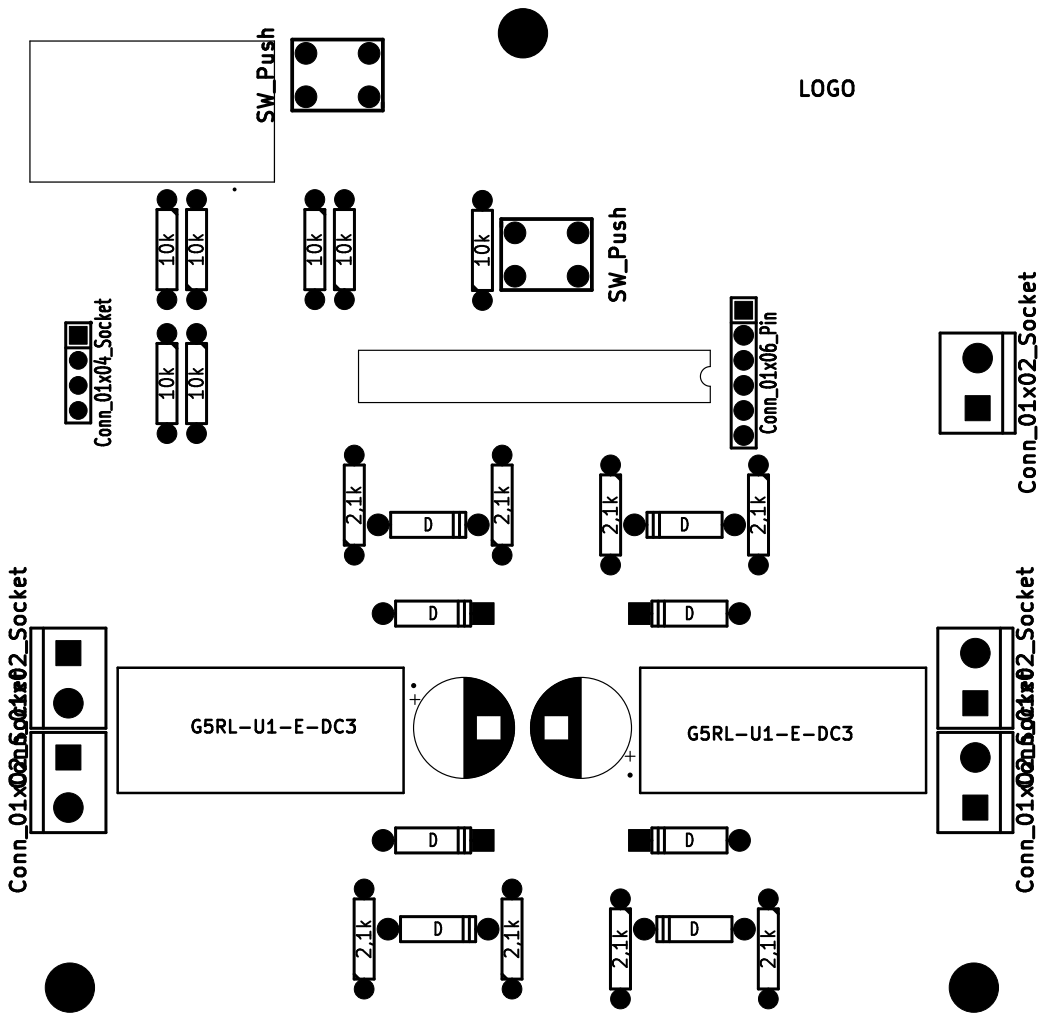
[picture p37: page 1]
