MathisRojas/Carte_Wifi/Electronique/Carte Wifi/V8_(Carte_1)/Plan_de_perçage.pdf

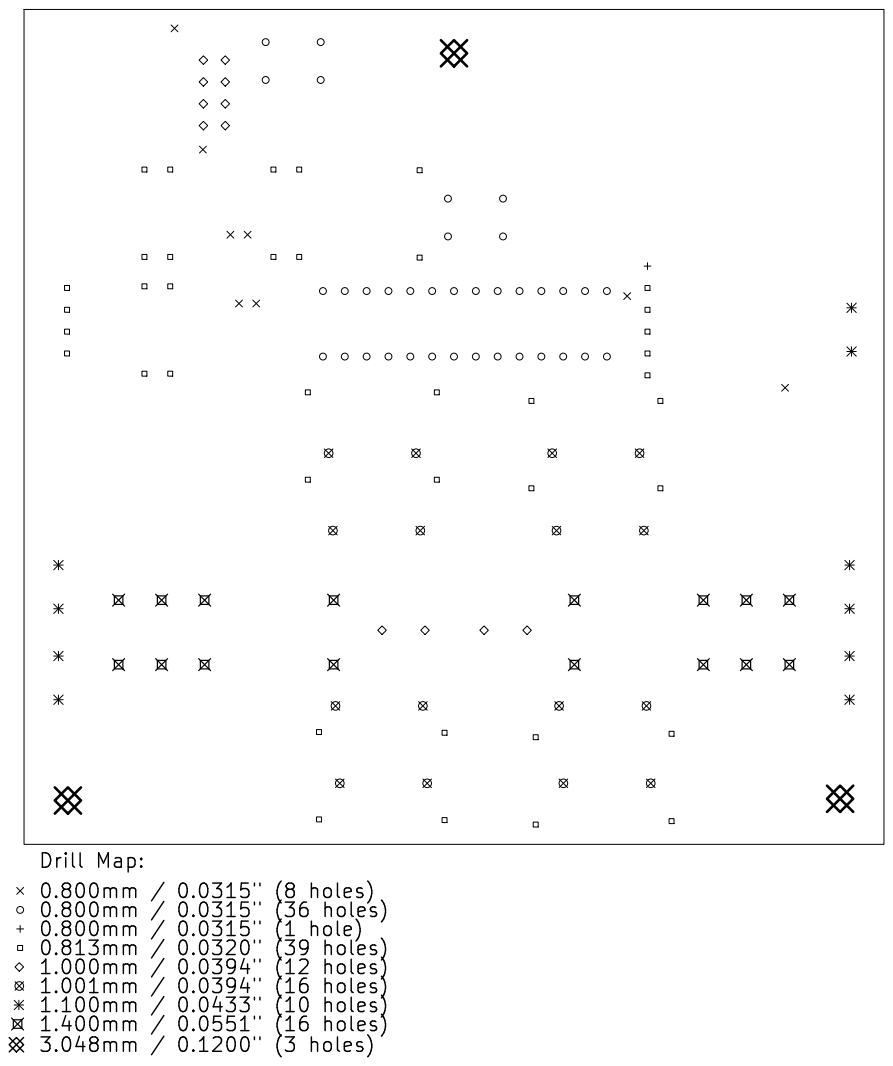
[picture p38: page 1]
