MathisRojas/Carte_Wifi/Electronique/Carte Wifi/V8_(Carte_1)/Typon_Bottom_Cu.pdf

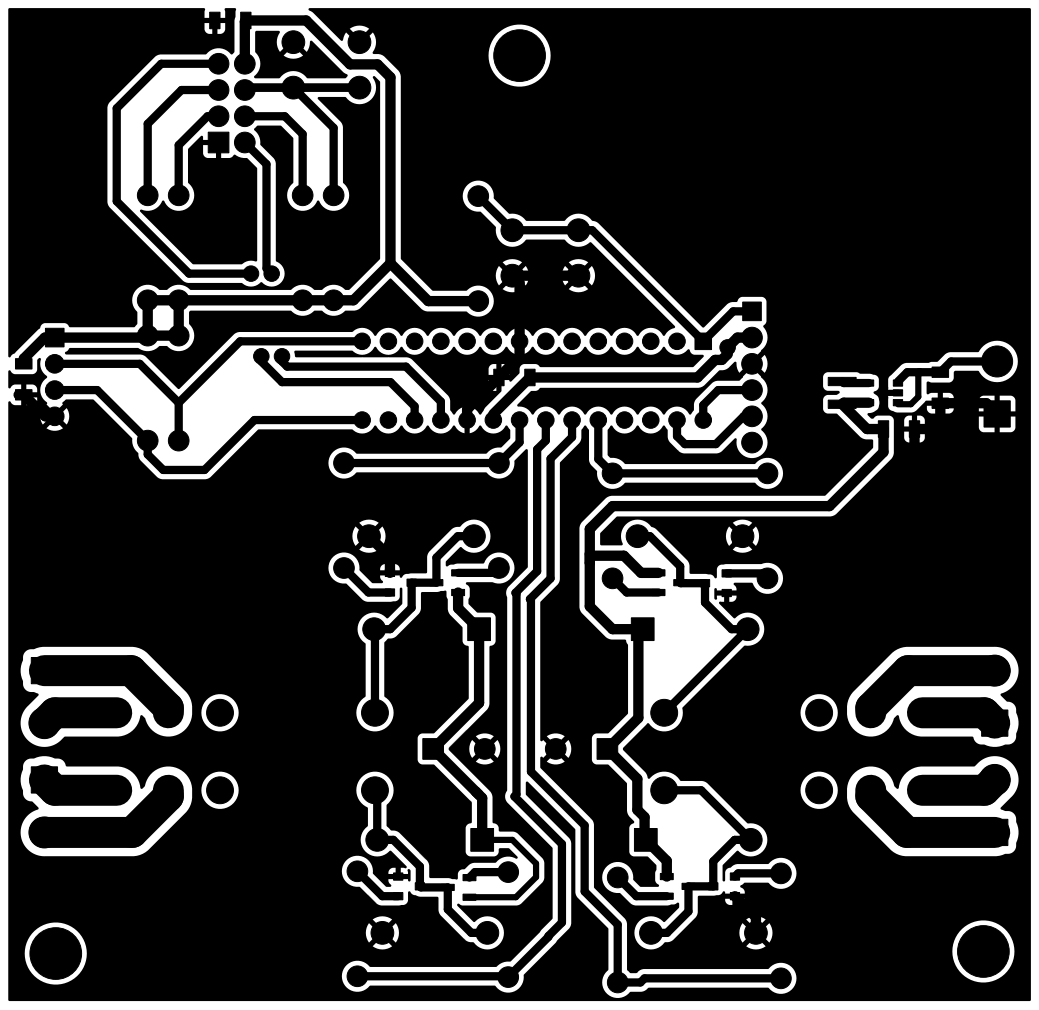
[picture p39: page 1]
