MathisRojas/Carte_Wifi/Electronique/Carte Wifi/V8_(Carte_1)/Typon_Front.pdf

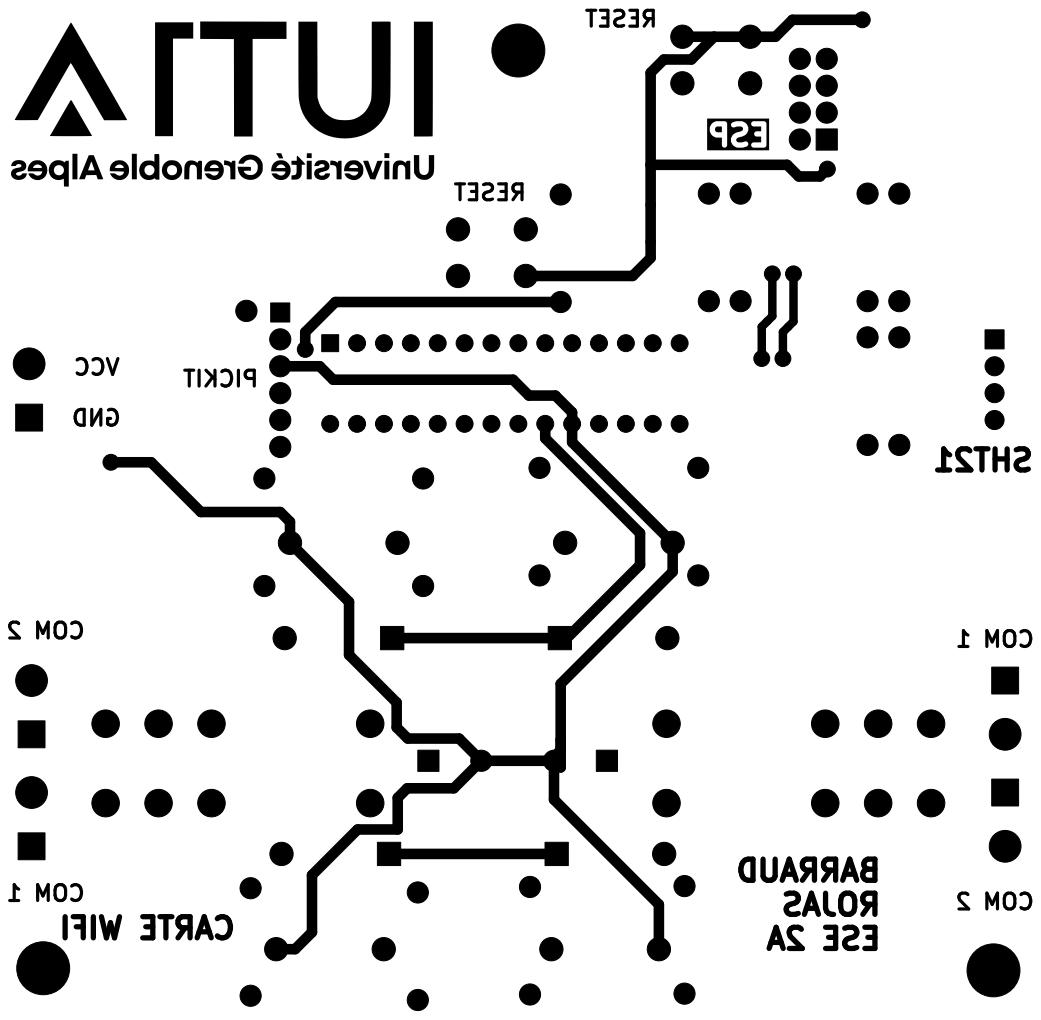
[picture p40: page 1]
