MathisRojas/Carte_Wifi/(list of files, drawings)

Other design files:
Electronique/bibliothèque/2SCR514RTL/Altium/2SCR514RTL.PcbLib
Electronique/bibliothèque/2SCR514RTL/Altium/2SCR514RTL.SchLib
Electronique/bibliothèque/SHT21/Altium/SHT21.SchLib
Electronique/bibliothèque/SHT21/Altium/SON100P300X300X110-7N-D.PcbLib
Electronique/bibliothèque/XC9236A33DMR-G/Altium/SOT95P280X130-5N.PcbLib
Electronique/bibliothèque/XC9236A33DMR-G/Altium/XC9236A33DMR-G.SchLib
