MathisRojas/Carte_Wifi/Electronique/Carte Wifi/V8_(Carte_1)/pcb.kicad_pcb

## KiCad design Electronique/Carte Wifi/V8_(Carte_1)/pcb.kicad_pcb (2025-04-15)

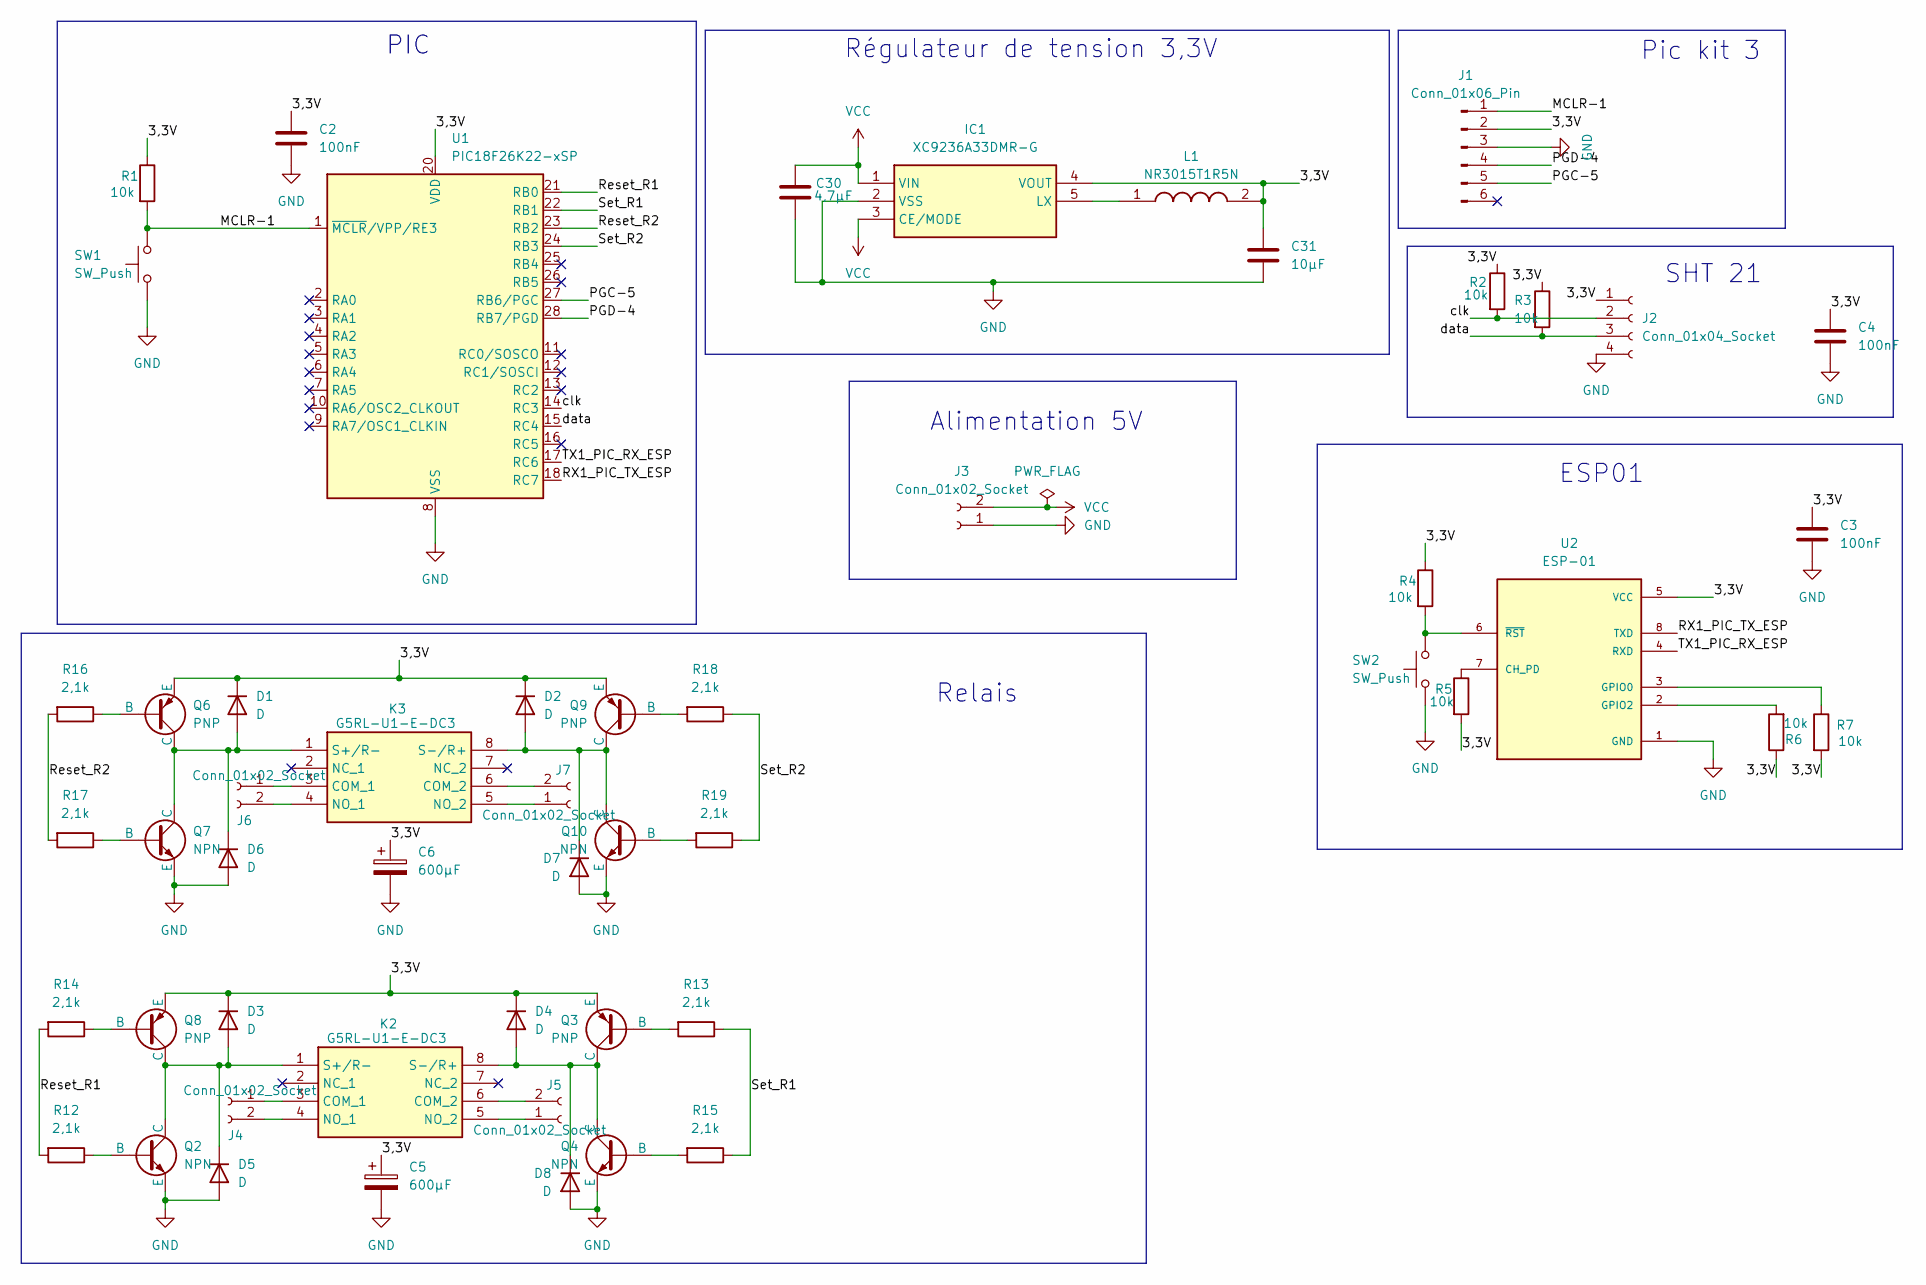
[picture p41: schematic pcb.kicad_sch, Carte Wifi]

Parts:
C2, C3, C4: 100nF; IUT_Capa_CMS_1206
C5, C6: 600µF; CP_Radial_D10.0mm_P5.00mm
C30: 4,7µF; IUT_Capa_CMS_1206
C31: 10µF; IUT_Capa_CMS_1206
D1, D2, D3, D4, D5, D6, D7, D8: D; IUT_Diode
IC1: XC9236A33DMR-G; SOT95P280X130-5N; Mouser Part Number 865-XC9236A33DMR-G
J1: Conn_01x06_Pin; IUT_SIL-6
J2: Conn_01x04_Socket; IUT_SIL-4
J3, J4, J5, J6, J7: Conn_01x02_Socket; IUT_bornier2
K2, K3: G5RL-U1-E-DC3; G5RLU1E; Mouser Part Number 653-G5RLU1EDC3
L1: NR3015T1R5N; NR3015; Mouser Part Number 963-NR3015T1R5N
Q2, Q4, Q7, Q10: NPN; 2SCR514RTL
Q3, Q6, Q8, Q9: PNP; SOT95P237X112-3N
R1, R2, R3, R4, R5, R6, R7: 10k; IUT_R4
R12, R13, R14, R15, R16, R17, R18, R19: 2,1k; IUT_R4
SW1, SW2: SW_Push; IUT_BP_petit
U1: PIC18F26K22-xSP; DIP-28_W7.62mm
U2: ESP-01; MODULE_ESP-01; PARTREV 1.0

Connections:
/3,3V: C2.1, C3.1, C4.1, C5.1, C6.1, C31.1, D1.1 (K), D2.1 (K), D3.1 (K), D4.1 (K), IC1.4 (VOUT), J1.2, J2.1, L1.2, Q3.2 (E), Q6.2 (E), Q8.2 (E), Q9.2 (E), R1.1, R2.1, R3.1, R4.1, R5.2, R6.1, R7.2, U1.20 (VDD), U2.5 (VCC)
/MCLR-1: J1.1, R1.2, SW1.2, U1.1 (~MCLR/VPP/RE3)
/PGC-5: J1.5, U1.27 (RB6/PGC)
/PGD-4: J1.4, U1.28 (RB7/PGD)
/RX1_PIC_TX_ESP: U1.18 (RC7), U2.8 (TXD)
/Reset_R1: R12.2, R14.2, U1.21 (RB0)
/Reset_R2: R16.2, R17.2, U1.23 (RB2)
/Set_R1: R13.1, R15.1, U1.22 (RB1)
/Set_R2: R18.1, R19.1, U1.24 (RB3)
/TX1_PIC_RX_ESP: U1.17 (RC6), U2.4 (RXD)
/clk: J2.2, R2.2, U1.14 (RC3)
/data: J2.3, R3.2, U1.15 (RC4)
GND: C2.2, C3.2, C4.2, C5.2, C6.2, C30.2, C31.2, D5.2 (A), D6.2 (A), D7.2 (A), D8.2 (A), IC1.2 (VSS), J1.3, J2.4, J3.1, Q2.2 (E), Q4.2 (E), Q7.2 (E), Q10.2 (E), SW1.1, SW2.1, U1.8 (VSS), U1.19 (VSS), U2.1 (GND)
unnamed: D1.2 (A), D6.1 (K), K3.1 (S+/R-), Q6.3 (C), Q7.3 (C)
unnamed: D2.2 (A), D7.1 (K), K3.8 (S-/R+), Q9.3 (C), Q10.3 (C)
unnamed: D3.2 (A), D5.1 (K), K2.1 (S+/R-), Q2.3 (C), Q8.3 (C)
unnamed: D4.2 (A), D8.1 (K), K2.8 (S-/R+), Q3.3 (C), Q4.3 (C)
unnamed: IC1.5 (LX), L1.1
unnamed: J4.1, K2.3 (COM_1)
unnamed: J4.2, K2.4 (NO_1)
unnamed: J5.1, K2.5 (NO_2)
unnamed: J5.2, K2.6 (COM_2)
unnamed: J6.1, K3.3 (COM_1)
unnamed: J6.2, K3.4 (NO_1)
unnamed: J7.1, K3.5 (NO_2)
unnamed: J7.2, K3.6 (COM_2)
unnamed: Q2.1 (B), R12.1
unnamed: Q3.1 (B), R13.2
unnamed: Q4.1 (B), R15.2
unnamed: Q6.1 (B), R16.1
unnamed: Q7.1 (B), R17.1
unnamed: Q8.1 (B), R14.1
unnamed: Q9.1 (B), R18.2
unnamed: Q10.1 (B), R19.2
unnamed: R5.1, U2.7 (CH_PD)
unnamed: R7.1, U2.3 (GPIO0)
unnamed: R6.2, U2.2 (GPIO2)
unnamed: R4.2, SW2.2, U2.6 (~RST)
VCC: C30.1, IC1.1 (VIN), IC1.3 (CE/MODE), J3.2

Notes on the sheet:
Relais
ESP01
Alimentation 5V
Régulateur de tension 3,3V
Pic kit 3
PIC
SHT 21

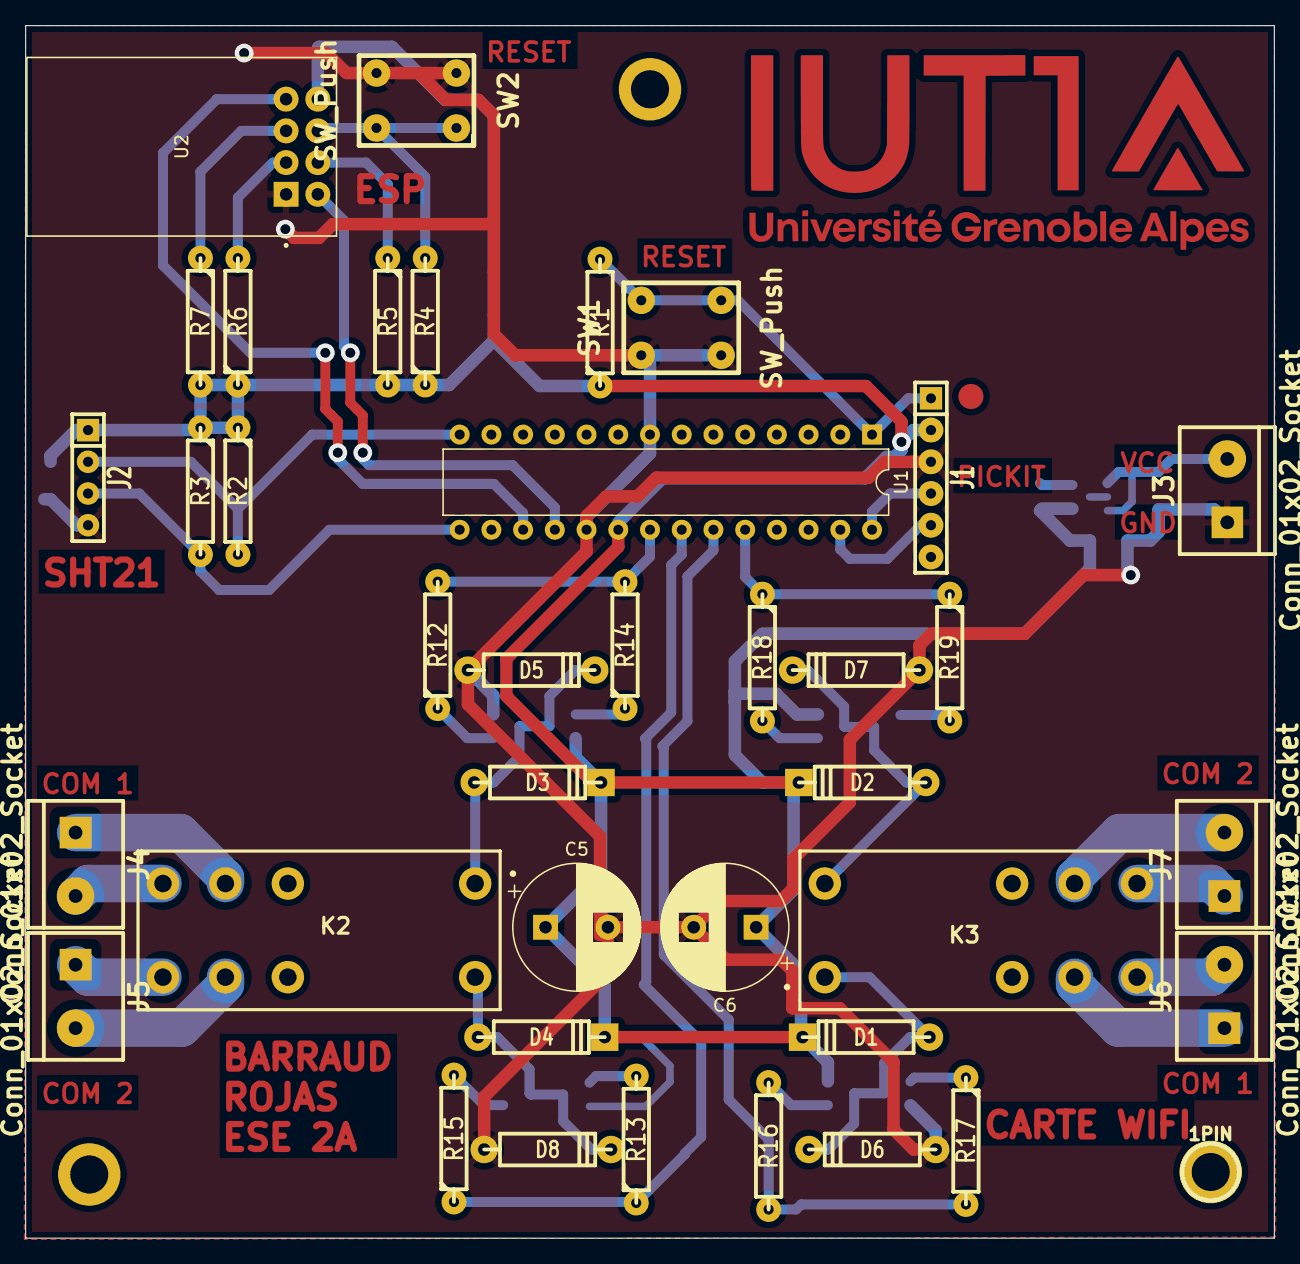
[picture p42: board Electronique/Carte Wifi/V8_(Carte_1)/pcb.kicad_pcb from above]

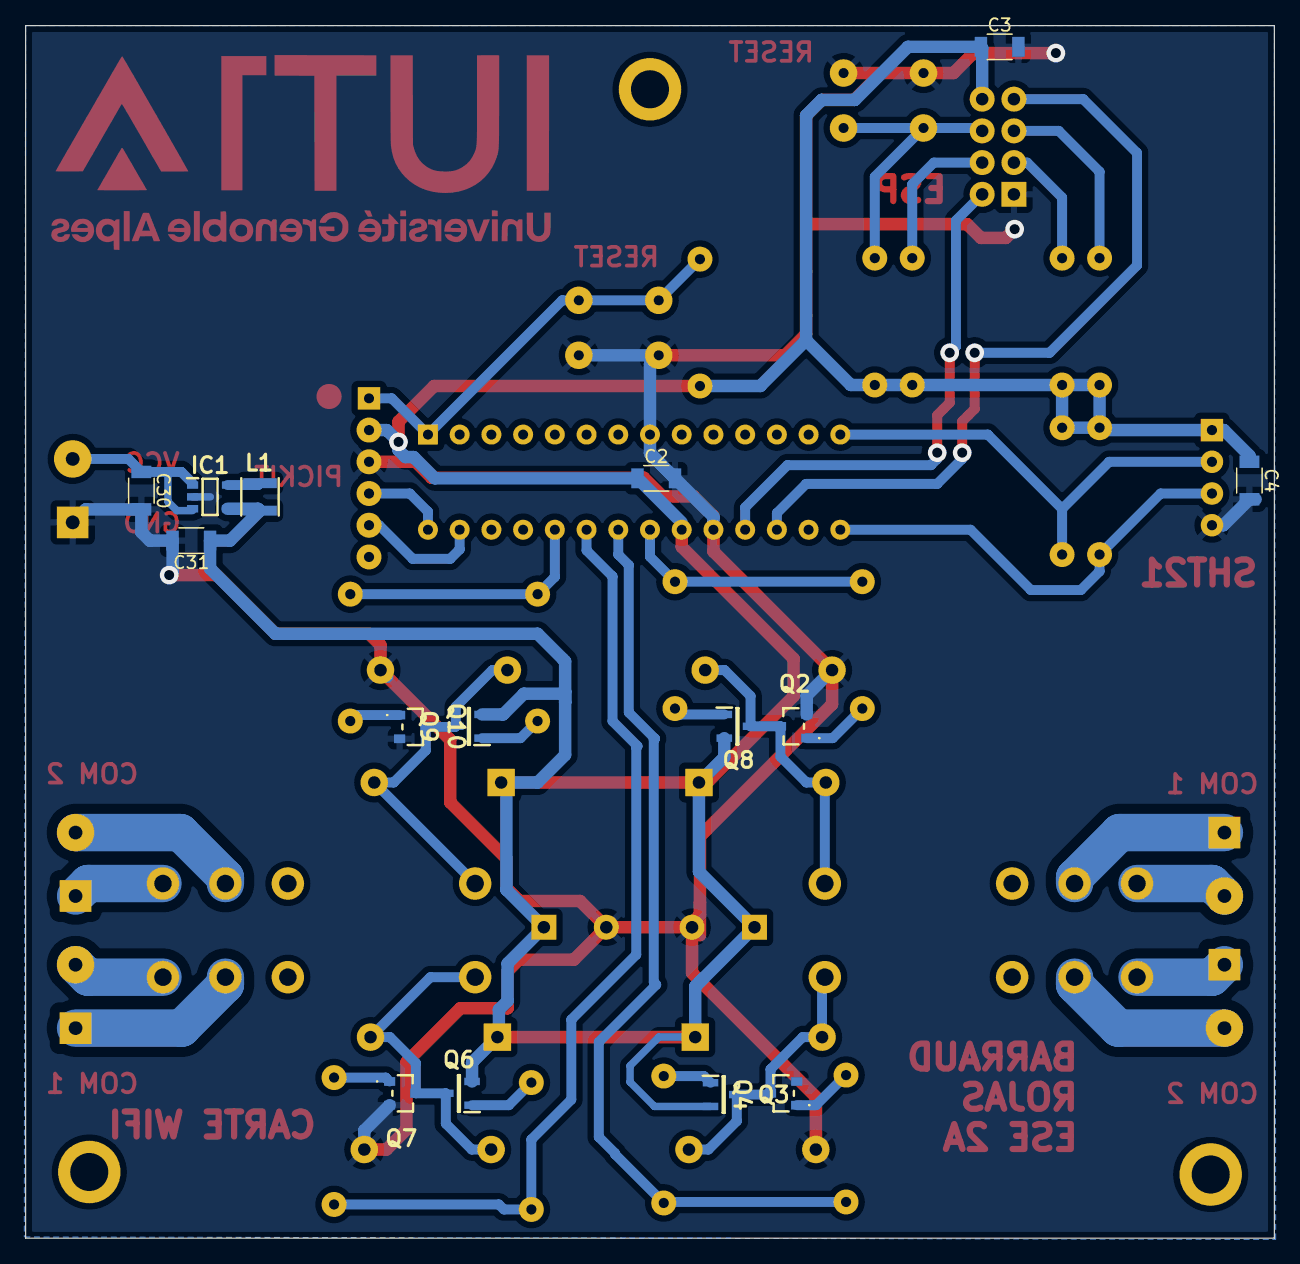
[picture p43: board Electronique/Carte Wifi/V8_(Carte_1)/pcb.kicad_pcb from below]

Board: 2 copper layers, 100.0 x 97.1 mm, 54 parts (15 on the bottom side), 39 nets.

Other parts of the board:
1PIN: P***; IUT_TrouFixation
