MathisRojas/Carte_Wifi/Electronique/Carte Wifi/V11_(Carte_2)/pcb.kicad_pcb

## KiCad design Electronique/Carte Wifi/V11_(Carte_2)/pcb.kicad_pcb (2025-04-15)

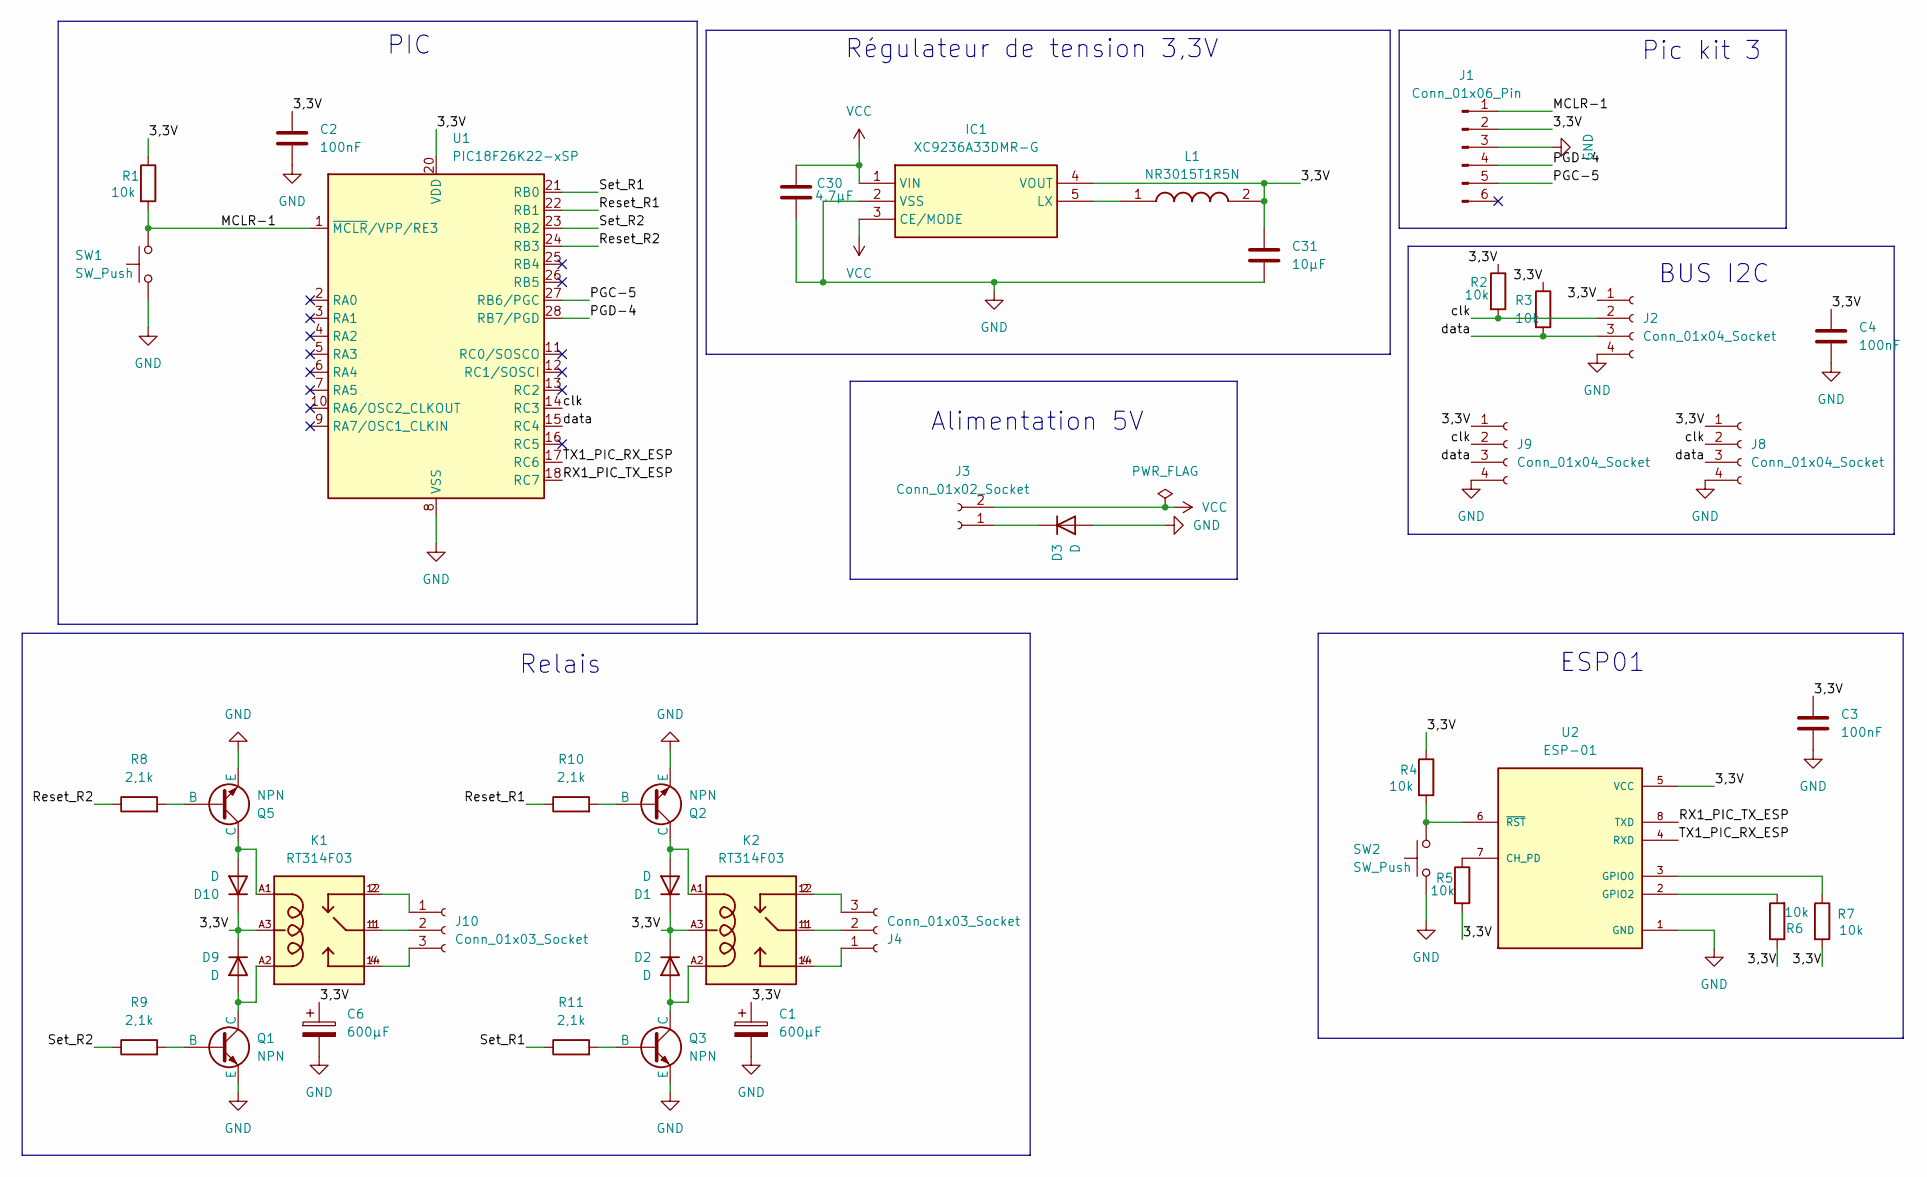
[picture p44: schematic pcb.kicad_sch, Carte Wifi]

Parts:
C1, C6: 600µF; CP_Radial_D10.0mm_P5.00mm
C2, C3, C4: 100nF; IUT_Capa_CMS_1206
C30: 4,7µF; IUT_Capa_CMS_1206
C31: 10µF; IUT_Capa_CMS_1206
D1, D2, D3, D9, D10: D; CR_SMA_403AE_OSI-L
IC1: XC9236A33DMR-G; SOT95P280X130-5N; Mouser Part Number 865-XC9236A33DMR-G
J1: Conn_01x06_Pin; IUT_SIL-6
J2, J8, J9: Conn_01x04_Socket; IUT_SIL-4
J3: Conn_01x02_Socket; IUT_bornier2
J4, J10: Conn_01x03_Socket; IUT_bornier3
K1, K2: RT314F03; RELAY_RT314F03; PARTREV 0717
L1: NR3015T1R5N; NR3015; Mouser Part Number 963-NR3015T1R5N
Q1, Q2, Q3, Q5: NPN; 2SCR514RTL
R1, R2, R3, R4, R5, R6, R7: 10k; R_0805_2012Metric
R8, R9, R10, R11: 2,1k; R_0805_2012Metric
SW1, SW2: SW_Push; IUT_BP_petit
U1: PIC18F26K22-xSP; SOP65P780X200-28N
U2: ESP-01; MODULE_ESP-01; PARTREV 1.0

Connections:
/3,3V: C1.1, C2.1, C3.1, C4.1, C6.1, C31.1, D1.1 (K), D2.1 (K), D9.1 (K), D10.1 (K), IC1.4 (VOUT), J1.2, J2.1, J8.1, J9.1, K1.A3, K2.A3, L1.2, R1.1, R2.1, R3.1, R4.1, R5.2, R6.1, R7.2, U1.20 (VDD), U2.5 (VCC)
/MCLR-1: J1.1, R1.2, SW1.2, U1.1 (~MCLR/VPP/RE3)
/PGC-5: J1.5, U1.27 (RB6/PGC)
/PGD-4: J1.4, U1.28 (RB7/PGD)
/RX1_PIC_TX_ESP: U1.18 (RC7), U2.8 (TXD)
/Reset_R1: R10.1, U1.22 (RB1)
/Reset_R2: R8.1, U1.24 (RB3)
/Set_R1: R11.1, U1.21 (RB0)
/Set_R2: R9.1, U1.23 (RB2)
/TX1_PIC_RX_ESP: U1.17 (RC6), U2.4 (RXD)
/clk: J2.2, J8.2, J9.2, R2.2, U1.14 (RC3)
/data: J2.3, J8.3, J9.3, R3.2, U1.15 (RC4)
GND: C1.2, C2.2, C3.2, C4.2, C6.2, C30.2, C31.2, D3.2 (A), IC1.2 (VSS), J1.3, J2.4, J8.4, J9.4, Q1.2 (E), Q2.2 (E), Q3.2 (E), Q5.2 (E), SW1.1, SW2.1, U1.8 (VSS), U1.19 (VSS), U2.1 (GND)
unnamed: D1.2 (A), K2.A1, Q2.3 (C)
unnamed: D2.2 (A), K2.A2, Q3.3 (C)
unnamed: D3.1 (K), J3.1
unnamed: D9.2 (A), K1.A2, Q1.3 (C)
unnamed: D10.2 (A), K1.A1, Q5.3 (C)
unnamed: IC1.5 (LX), L1.1
unnamed: J4.1, K2.4, K2.14
unnamed: J4.2, K2.1, K2.11
unnamed: J4.3, K2.2, K2.12
unnamed: J10.1, K1.2, K1.12
unnamed: J10.2, K1.1, K1.11
unnamed: J10.3, K1.4, K1.14
unnamed: Q1.1 (B), R9.2
unnamed: Q2.1 (B), R10.2
unnamed: Q3.1 (B), R11.2
unnamed: Q5.1 (B), R8.2
unnamed: R5.1, U2.7 (CH_PD)
unnamed: R7.1, U2.3 (GPIO0)
unnamed: R6.2, U2.2 (GPIO2)
unnamed: R4.2, SW2.2, U2.6 (~RST)
VCC: C30.1, IC1.1 (VIN), IC1.3 (CE/MODE), J3.2

Notes on the sheet:
Relais
ESP01
Alimentation 5V
Régulateur de tension 3,3V
Pic kit 3
PIC
BUS I2C

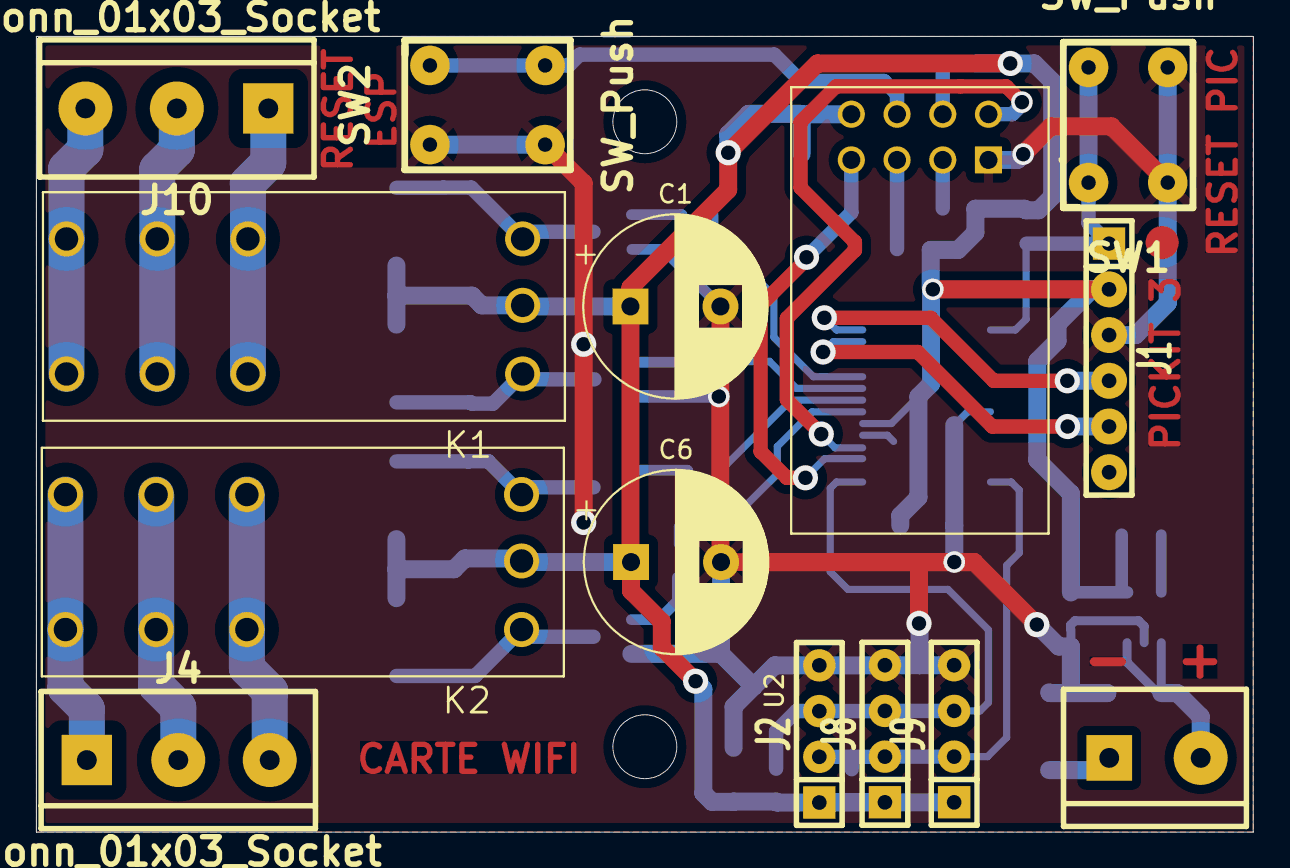
[picture p45: board Electronique/Carte Wifi/V11_(Carte_2)/pcb.kicad_pcb from above]

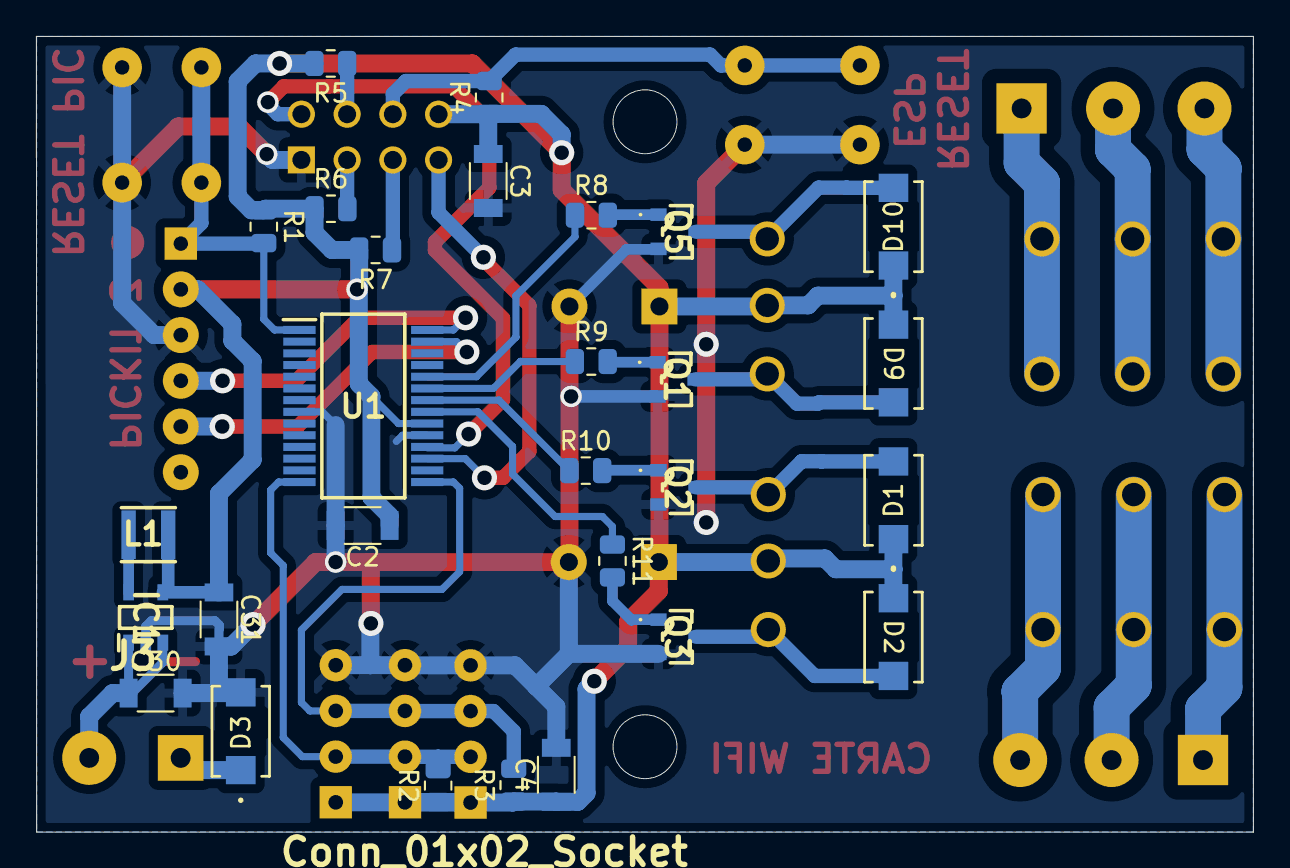
[picture p46: board Electronique/Carte Wifi/V11_(Carte_2)/pcb.kicad_pcb from below]

Board: 2 copper layers, 67.6 x 44.2 mm, 42 parts (28 on the bottom side), 34 nets.
